mkulesh/digitalAmplifier/photos/Amplifiers/PAM8320.jpg

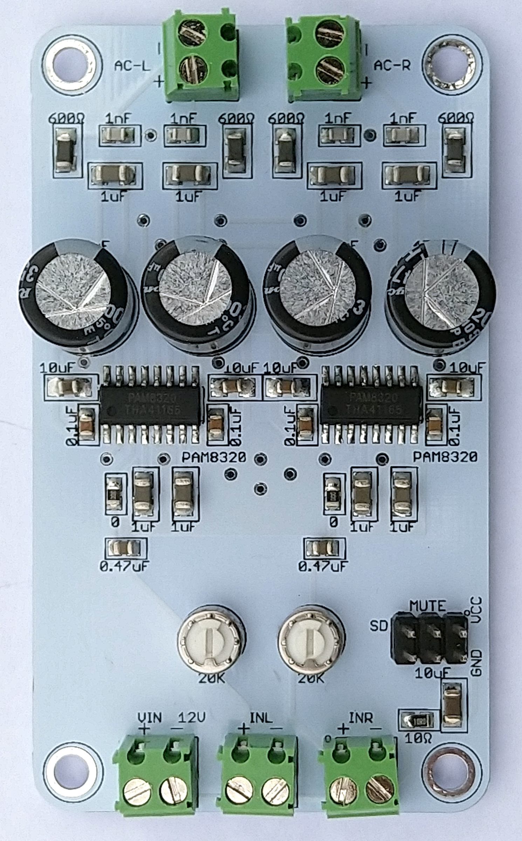
photos/Amplifiers/PAM8320.jpg
