mkulesh/digitalAmplifier/photos/Amplifiers/TPA3125.jpg

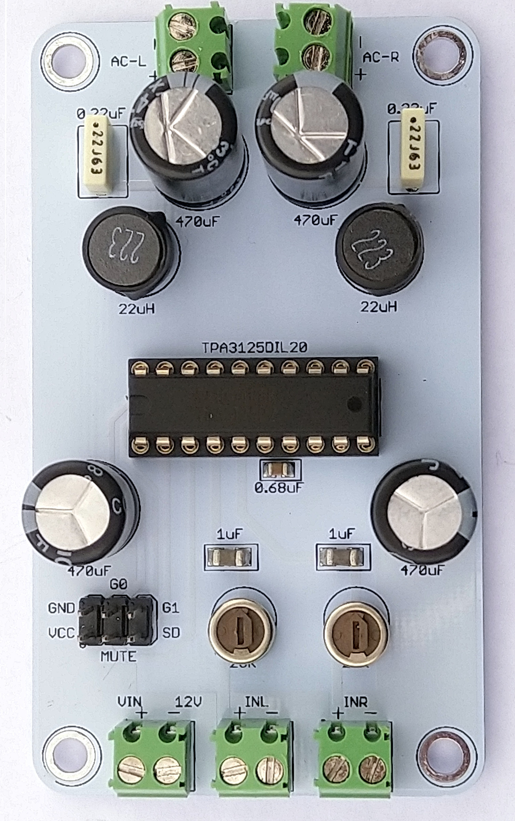
photos/Amplifiers/TPA3125.jpg
