mkulesh/digitalAmplifier/README.md

# digitalAmplifier
Class-D amplifier with MCU controll
