mkulesh/digitalAmplifier/photos/Amplifiers/MP7740.jpg

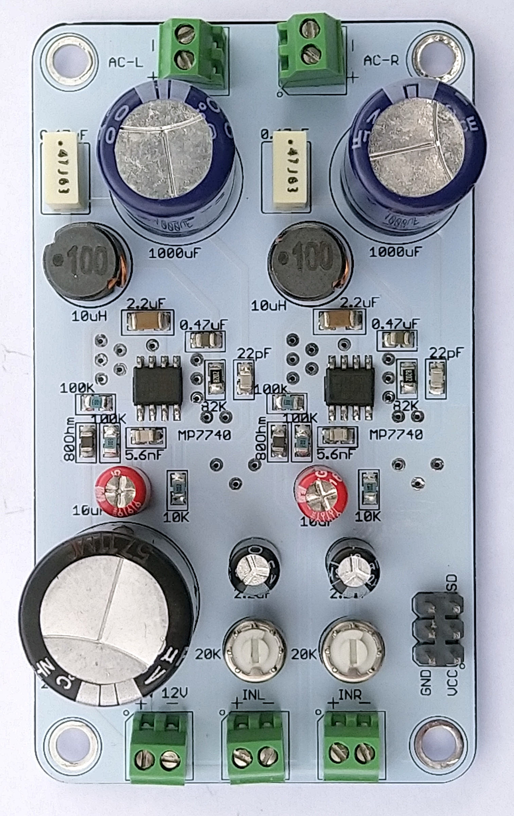
photos/Amplifiers/MP7740.jpg
