mkulesh/digitalAmplifier/photos/Amplifiers/PAM8320-proto.jpg

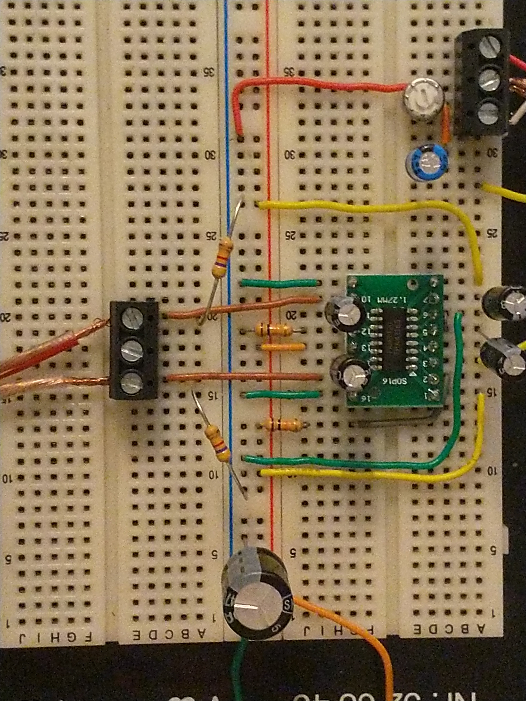
photos/Amplifiers/PAM8320-proto.jpg
