mkulesh/digitalAmplifier/photos/Amplifiers/TDA7297-proto.jpg

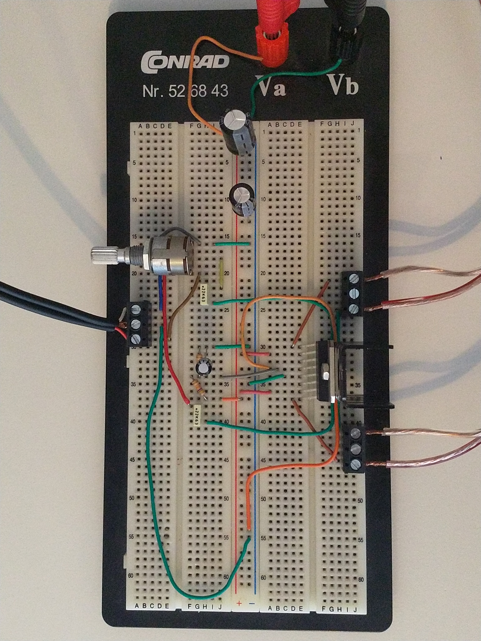
photos/Amplifiers/TDA7297-proto.jpg
