mkulesh/digitalAmplifier/photos/Amplifiers/TPA3125-proto.jpg

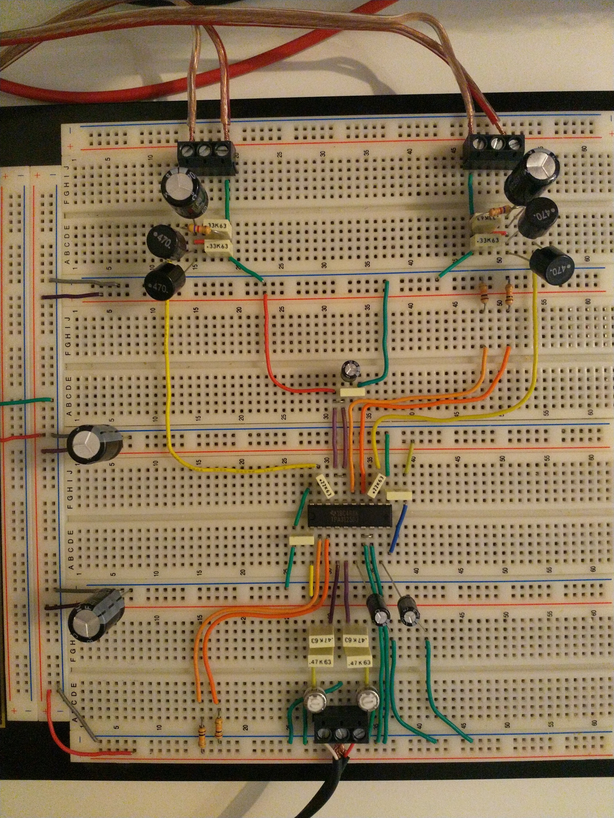
photos/Amplifiers/TPA3125-proto.jpg
