mkulesh/digitalAmplifier/photos/Chasis/Chasis3.jpg

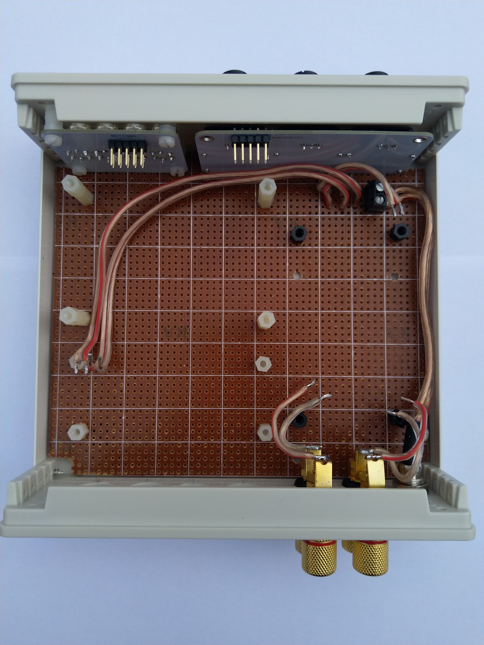
photos/Chasis/Chasis3.jpg
