mkulesh/digitalAmplifier/photos/Inside2.jpg

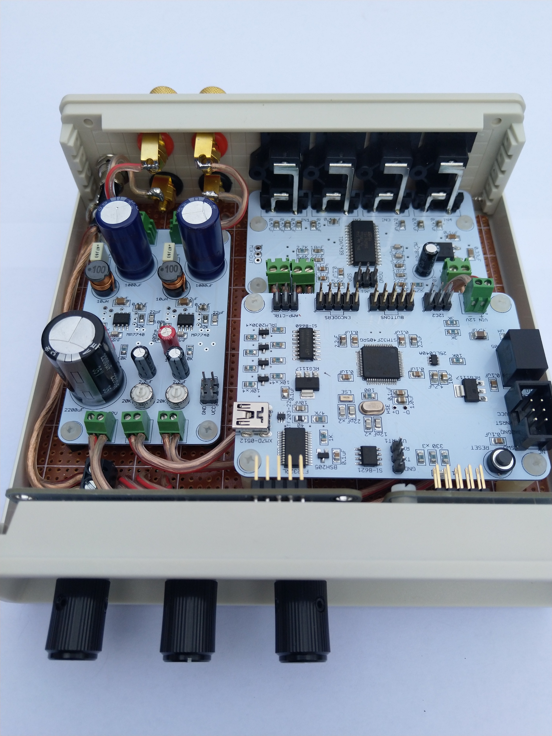
photos/Inside2.jpg
