mkulesh/digitalAmplifier/photos/Modules.jpg

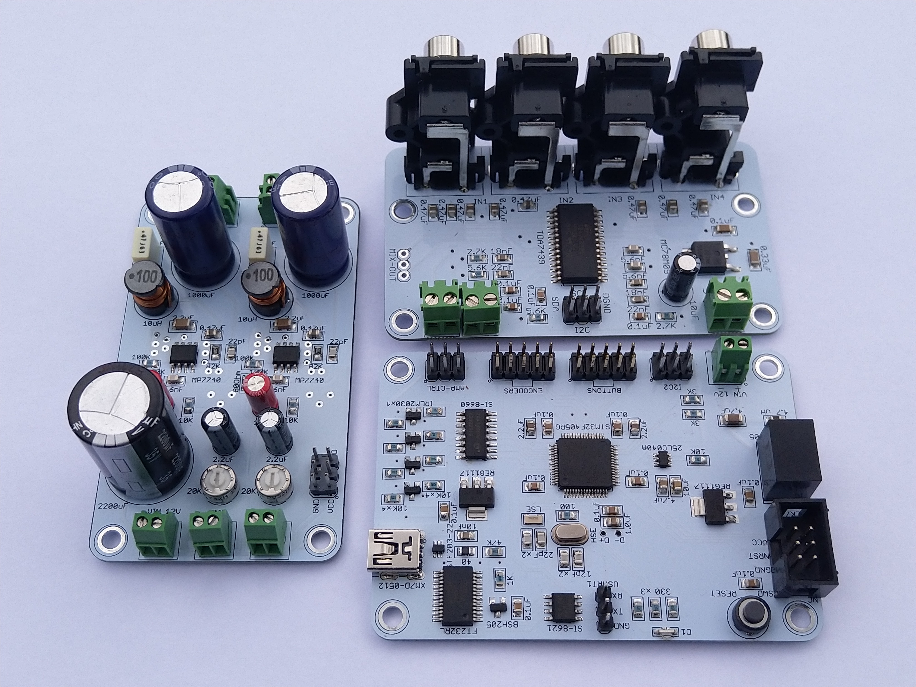
photos/Modules.jpg
