mkulesh/digitalAmplifier/photos/PreAmp/pre-amp.jpg

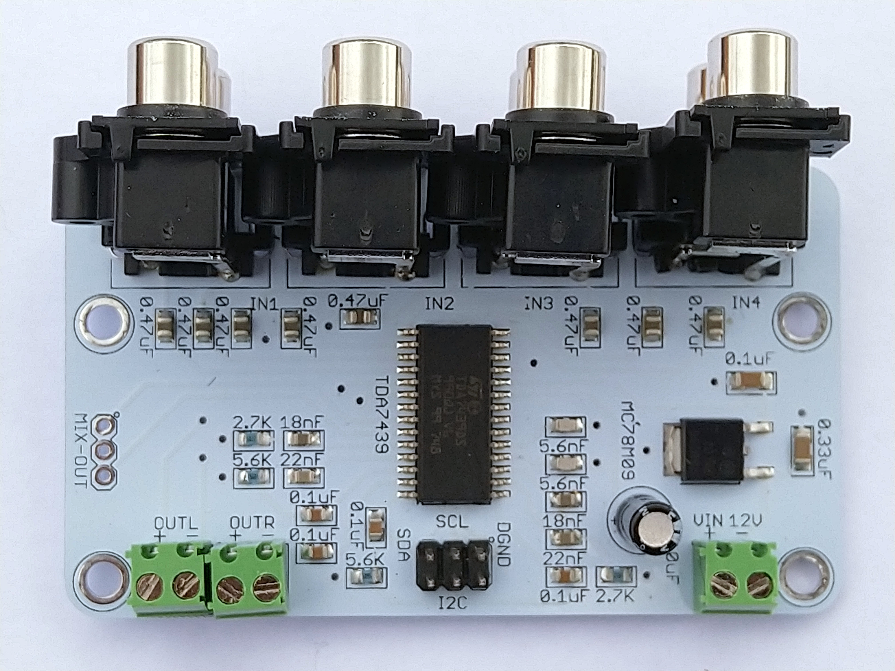
photos/PreAmp/pre-amp.jpg
