mkulesh/digitalAmplifier/photos/Prototypes/Prototype1.jpg

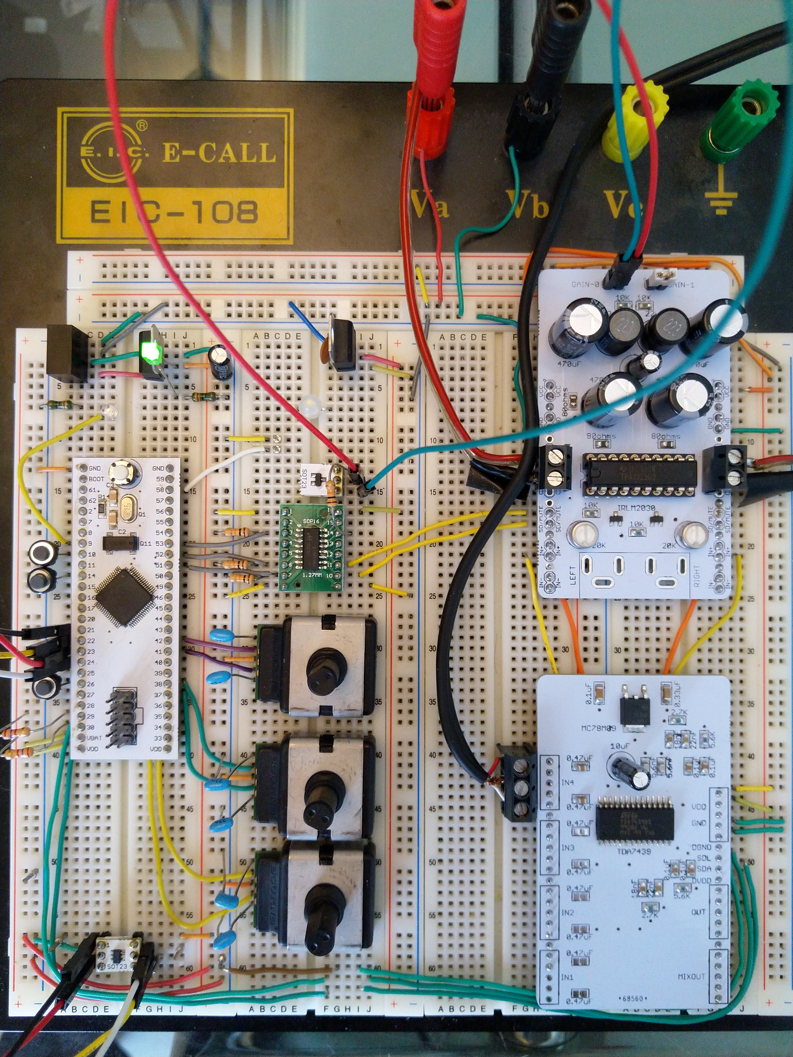
photos/Prototypes/Prototype1.jpg
