mkulesh/digitalAmplifier/photos/Prototypes/Prototype2.jpg

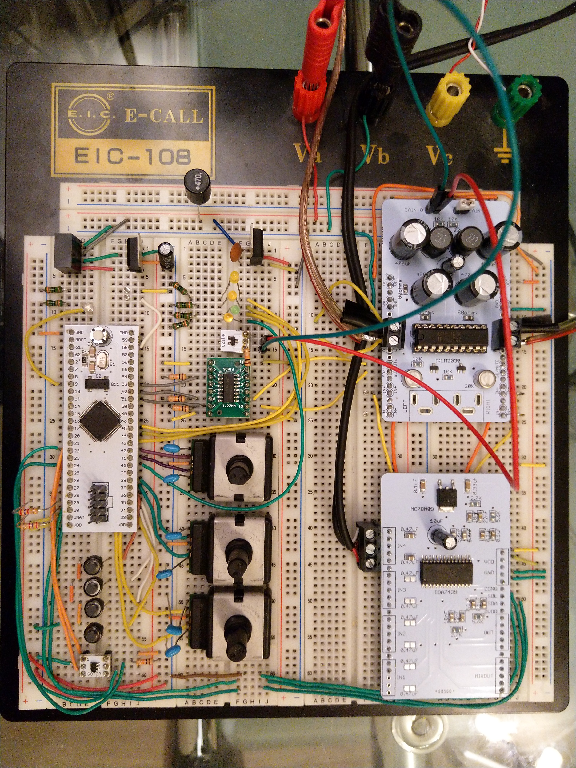
photos/Prototypes/Prototype2.jpg
