mkulesh/digitalAmplifier/photos/Prototypes/Prototype3.jpg

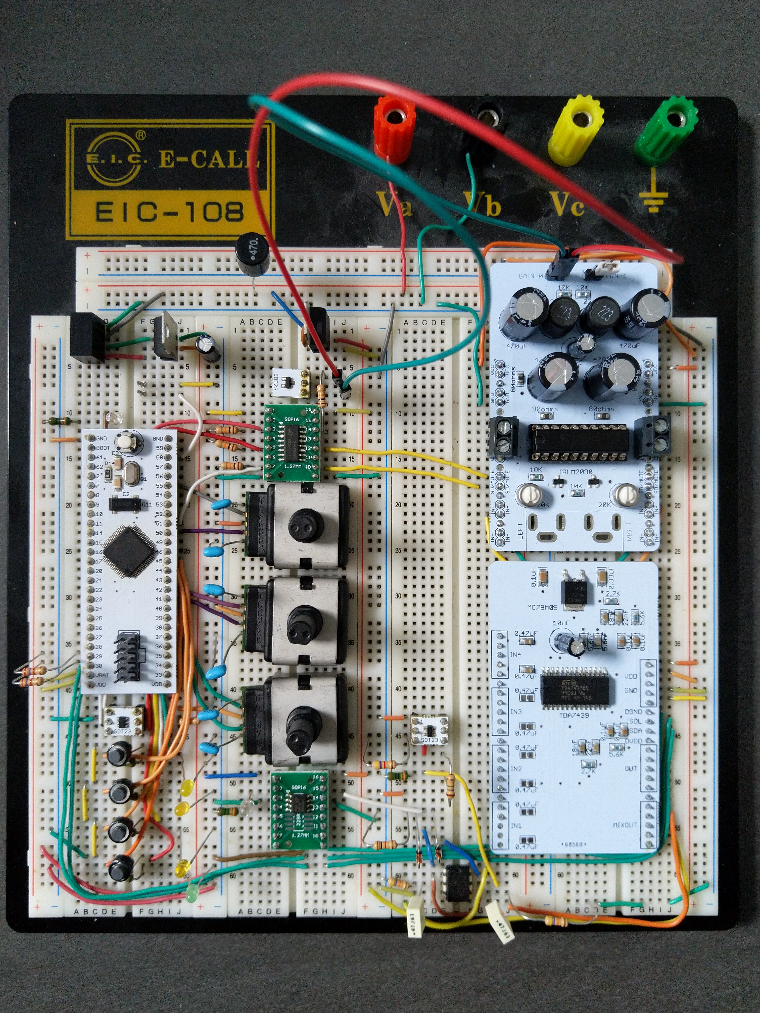
photos/Prototypes/Prototype3.jpg
