mkulesh/digitalAmplifier/photos/Amplifiers/MP7740-schematic.pdf

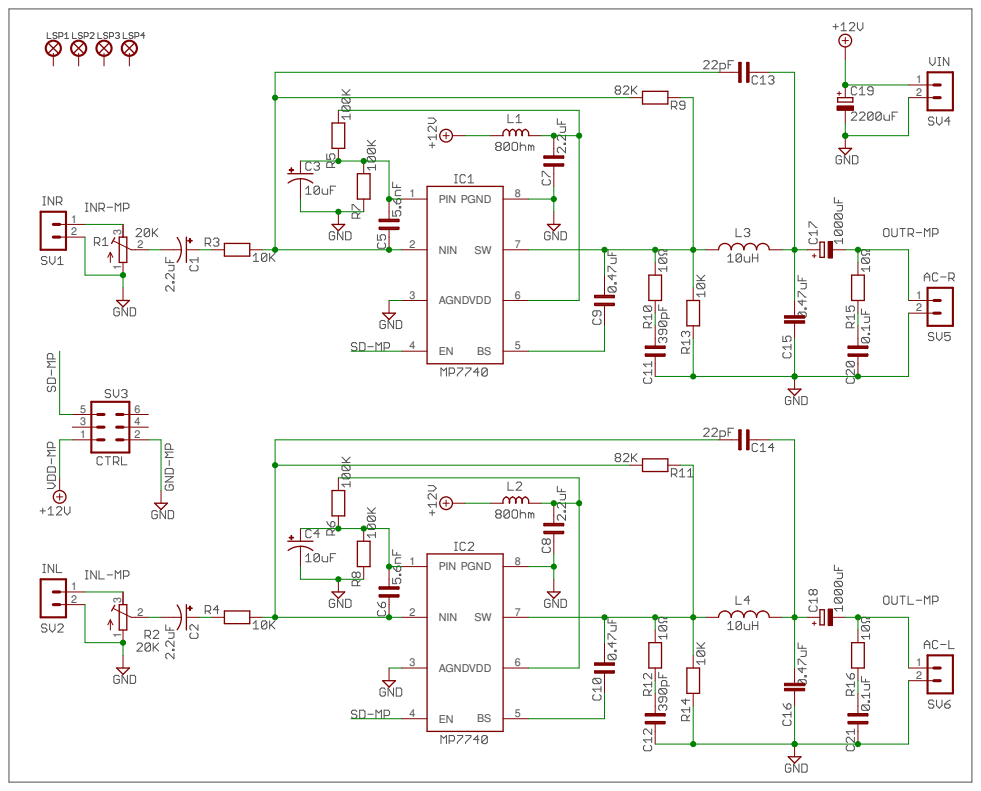
[picture p14: page 1]

1 3 2 1 3 2 1212 1212 135 246 12 PIN 1 NIN 2 AGND 3 EN 4 BS 5 VDD 6 SW 7 PGND 8 PIN 1 NIN 2 AGND 3 EN 4 BS 5 VDD 6 SW 7 PGND 8
