mkulesh/digitalAmplifier/photos/Amplifiers/PAM8320-schematic.pdf

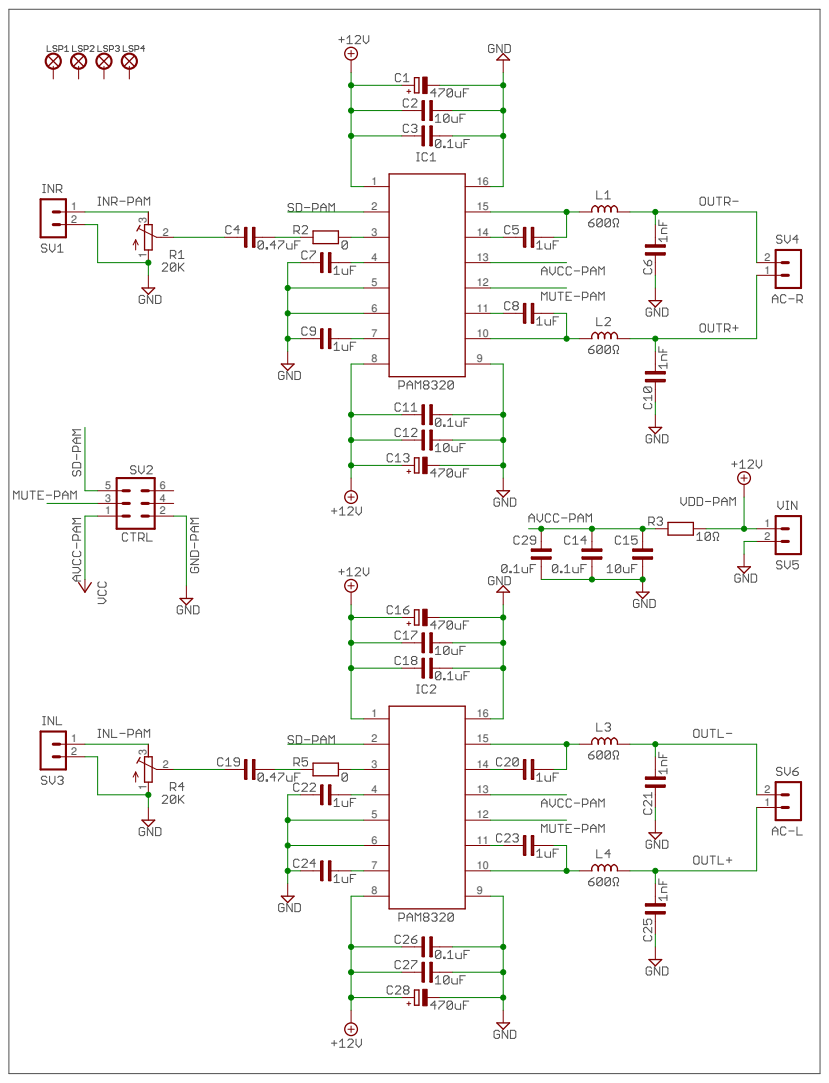
[picture p15: page 1]
