mkulesh/digitalAmplifier/photos/Amplifiers/TPA3125-schematic.pdf

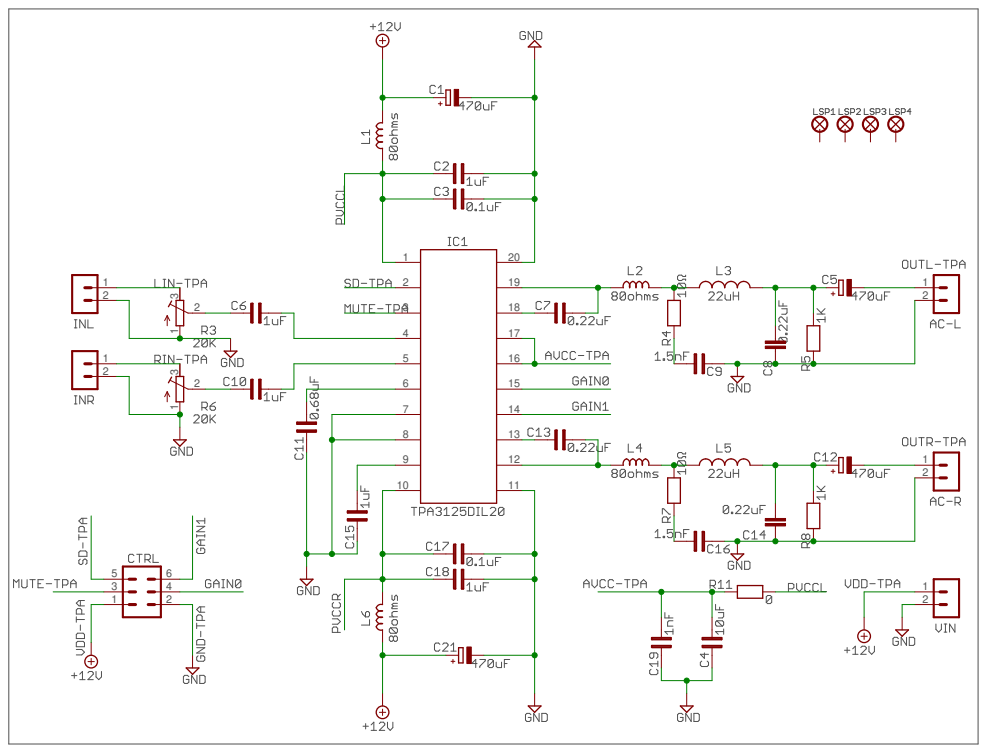
[picture p16: page 1]
