mkulesh/digitalAmplifier/photos/Mcu/mcu-components.pdf

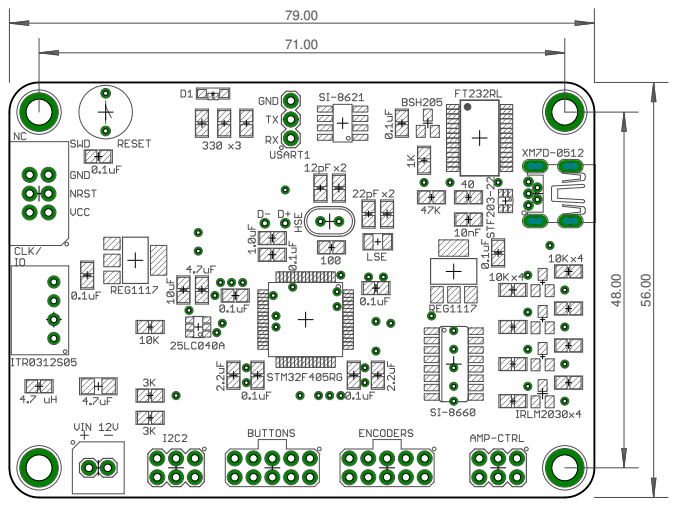
[picture p17: page 1]
