mkulesh/digitalAmplifier/photos/Mcu/mcu-schematic.pdf

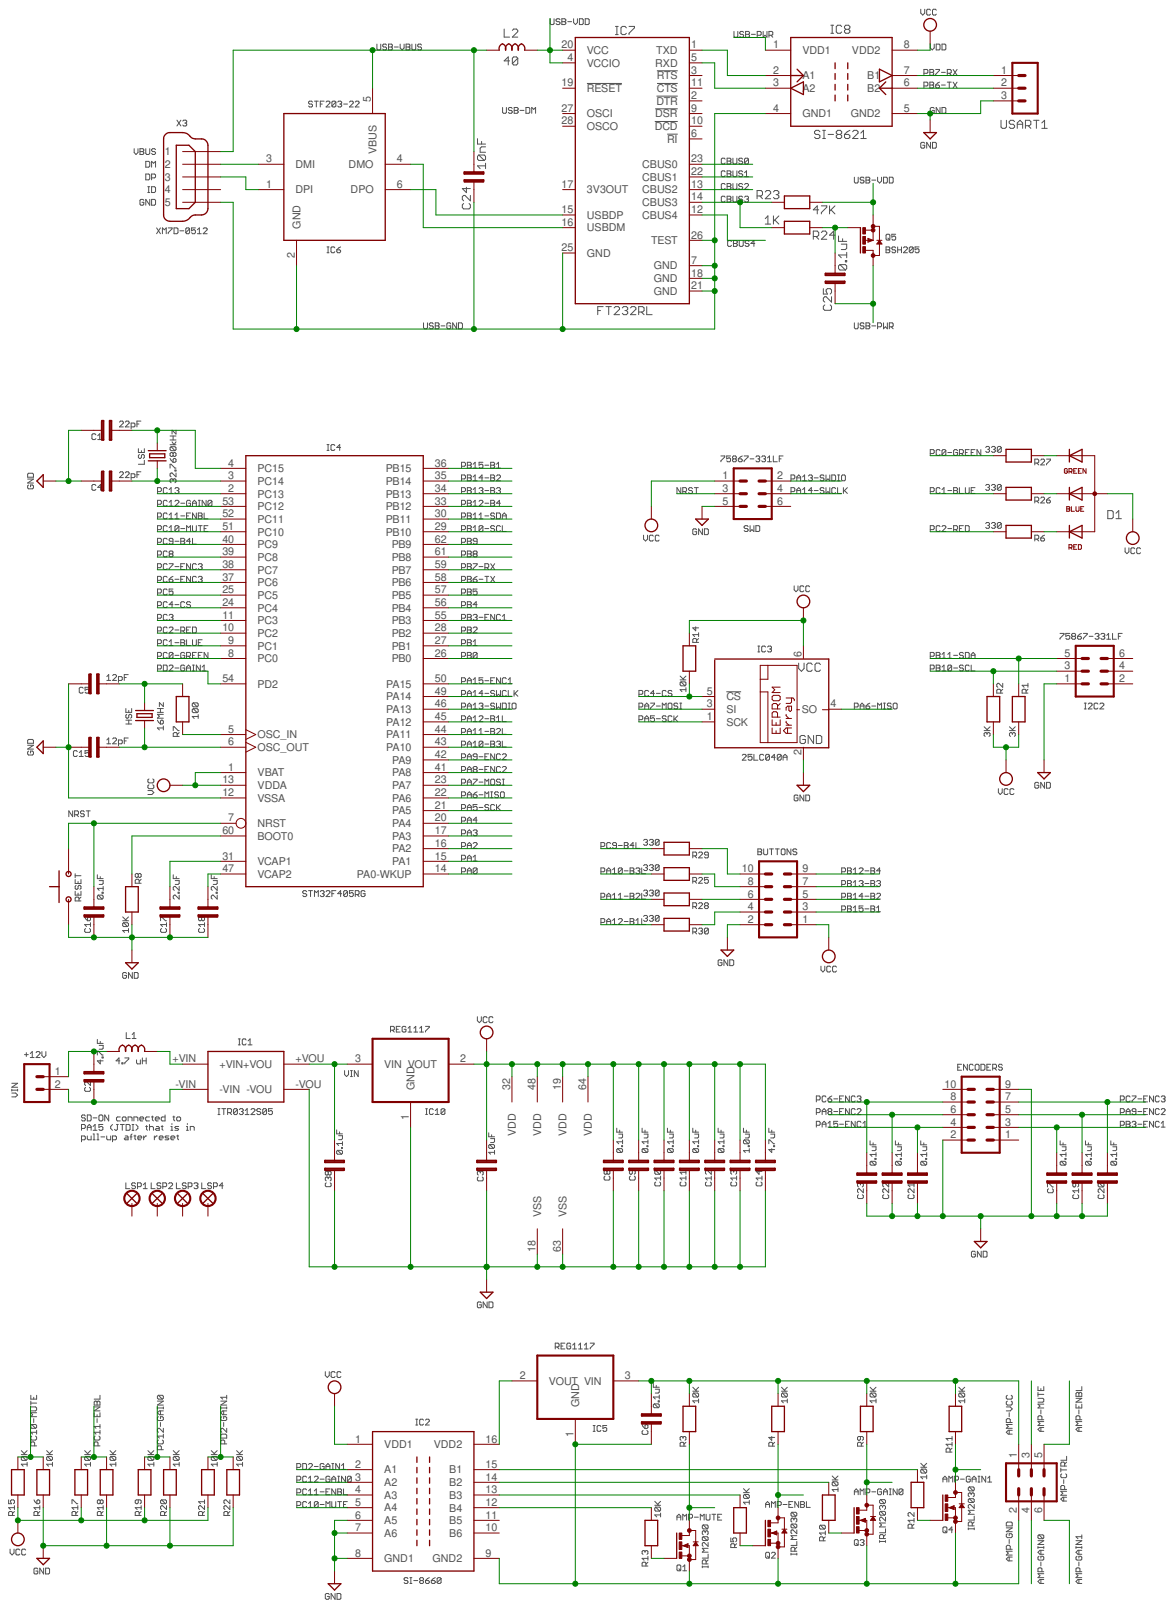
[picture p18: page 1]
