mkulesh/digitalAmplifier/photos/PreAmp/pre-amp-components.pdf

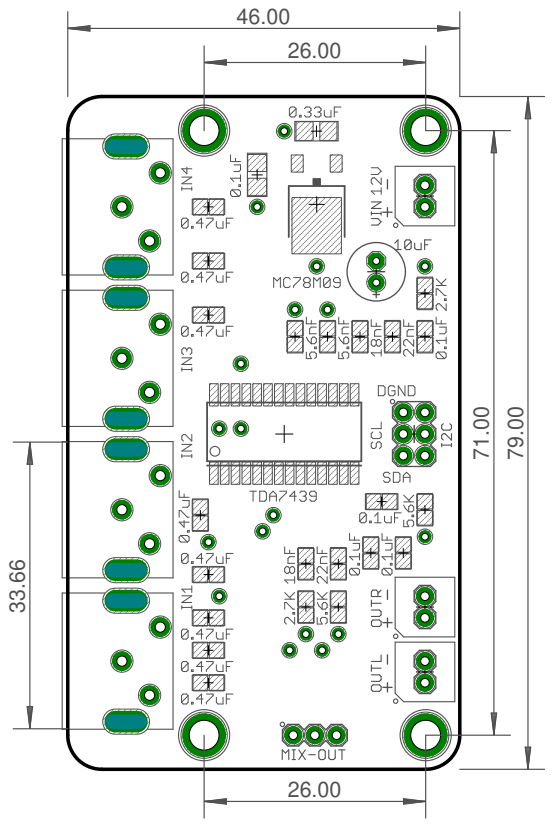
[picture p19: page 1]
