mkulesh/digitalAmplifier/photos/PreAmp/pre-amp-schematic.pdf

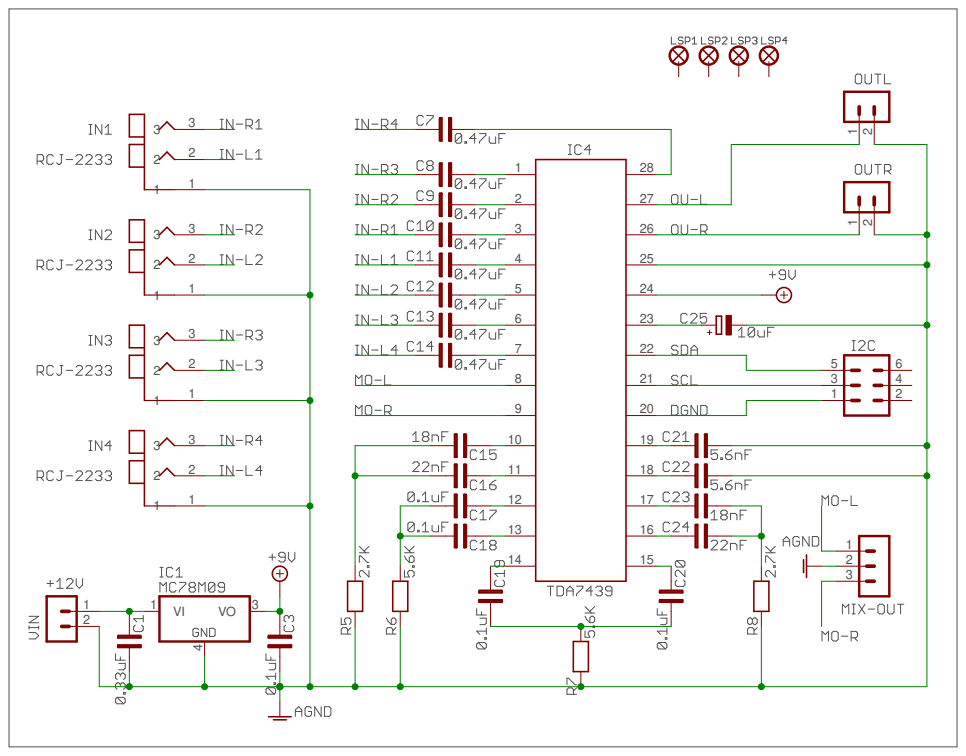
[picture p20: page 1]
