mkulesh/digitalAmplifier/photos/Amplifiers/MP7740-bottom.pdf

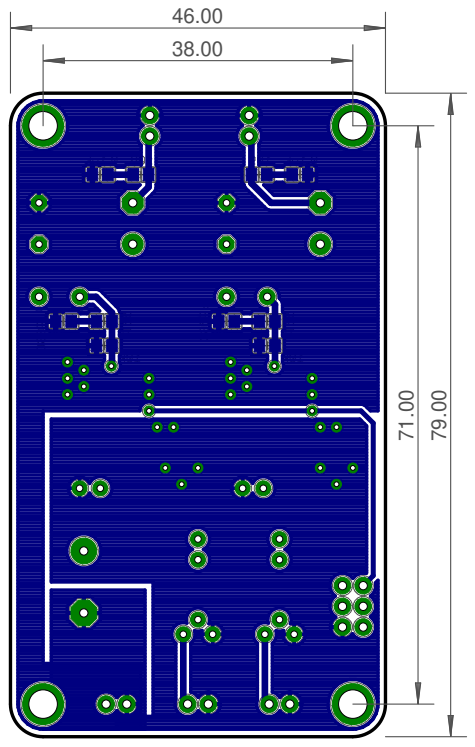
[picture p21: page 1]
