mkulesh/digitalAmplifier/photos/Amplifiers/MP7740-top.pdf

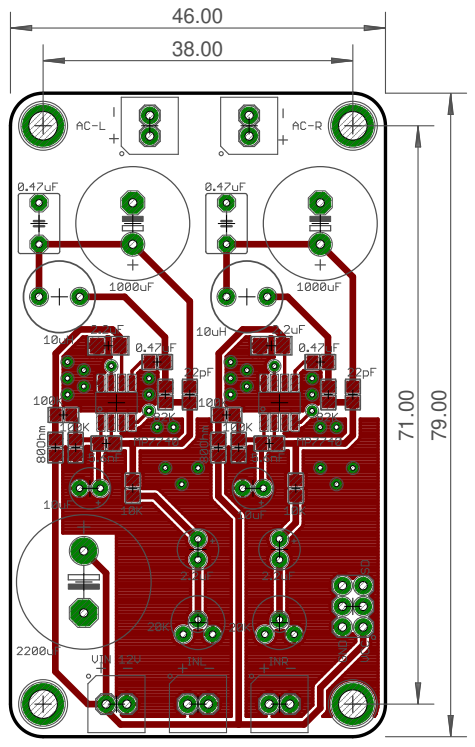
[picture p22: page 1]
