mkulesh/digitalAmplifier/photos/Amplifiers/PAM8320-bottom.pdf

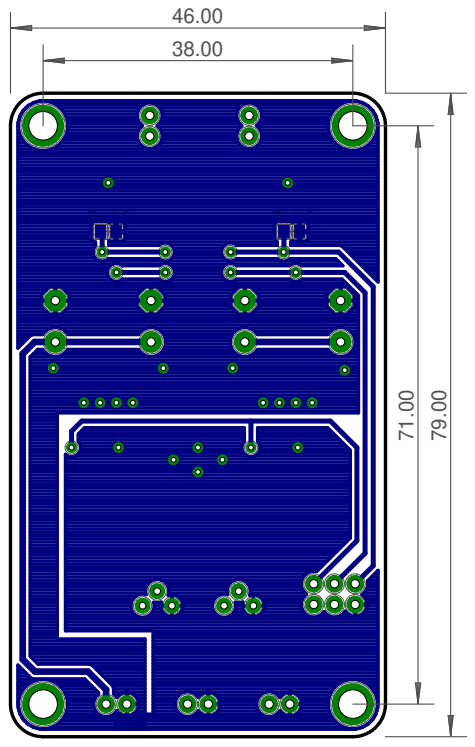
[picture p23: page 1]
