mkulesh/digitalAmplifier/photos/Amplifiers/PAM8320-top.pdf

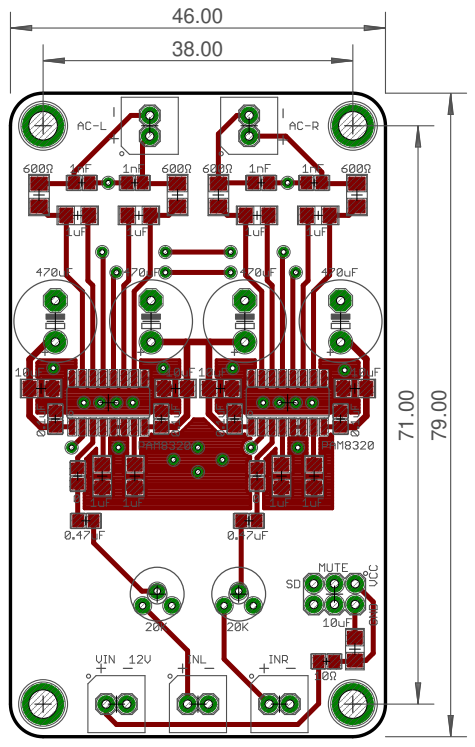
[picture p24: page 1]
