mkulesh/digitalAmplifier/photos/Amplifiers/TPA3125-bottom.pdf

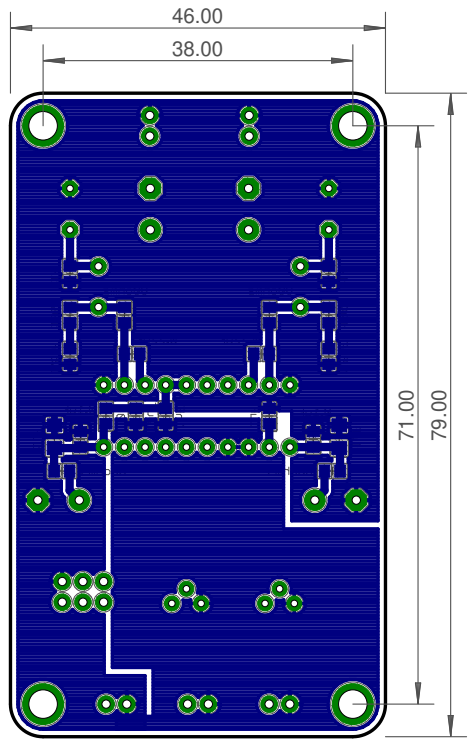
[picture p25: page 1]
