mkulesh/digitalAmplifier/photos/Amplifiers/TPA3125-top.pdf

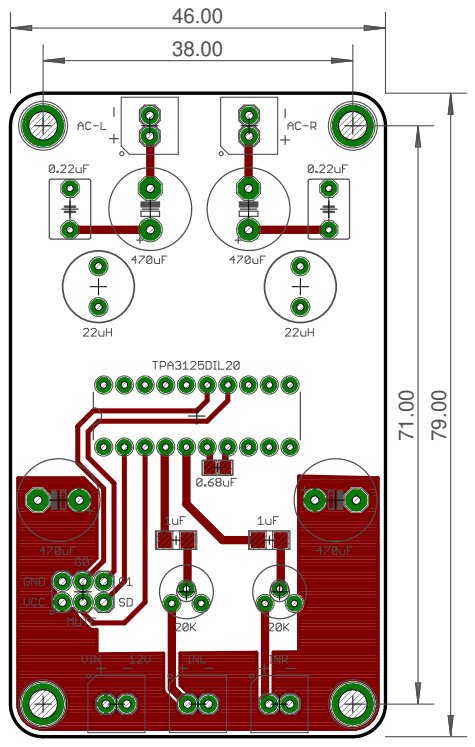
[picture p26: page 1]
