mkulesh/digitalAmplifier/photos/Mcu/mcu-bottom.pdf

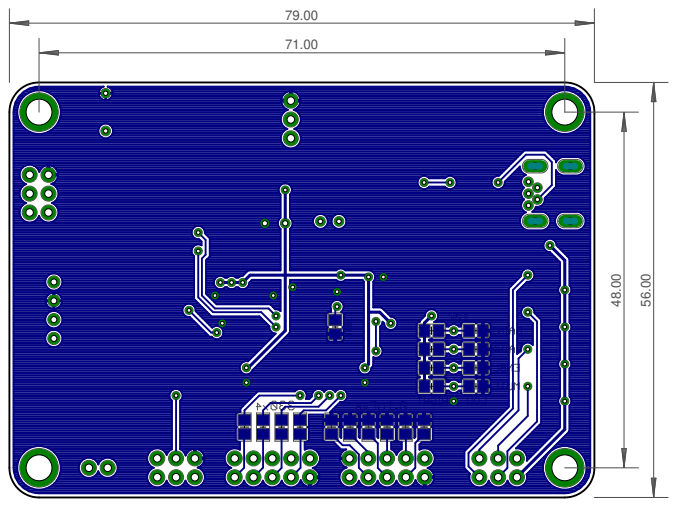
[picture p27: page 1]
