mkulesh/digitalAmplifier/photos/Mcu/mcu-top.pdf

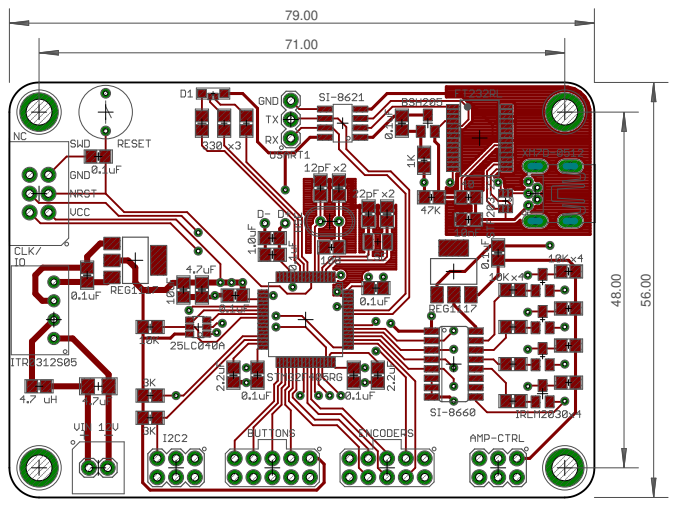
[picture p28: page 1]
