mkulesh/digitalAmplifier/photos/PreAmp/pre-amp-bottom.pdf

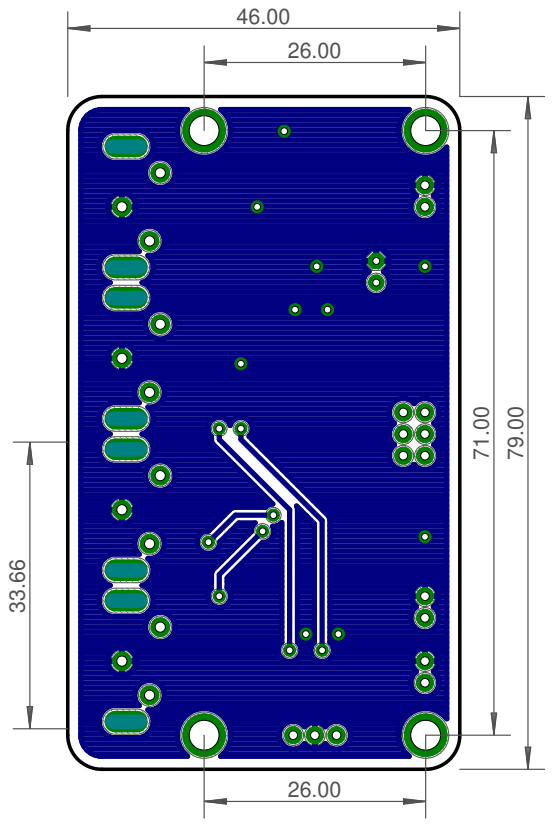
[picture p29: page 1]
