mkulesh/digitalAmplifier/photos/PreAmp/pre-amp-top.pdf

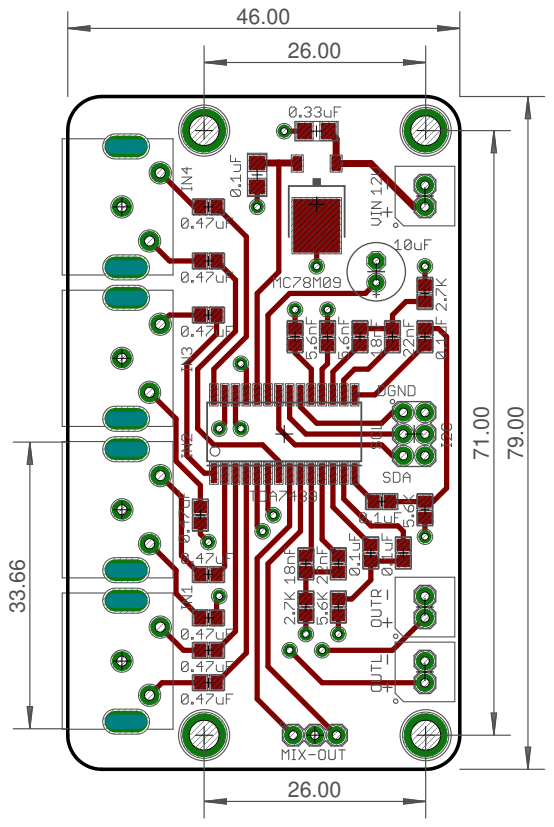
[picture p30: page 1]
