mkulesh/digitalAmplifier/pcb/module-tpa3125.brd

## EAGLE design pcb/module-tpa3125.brd (2021-05-24)

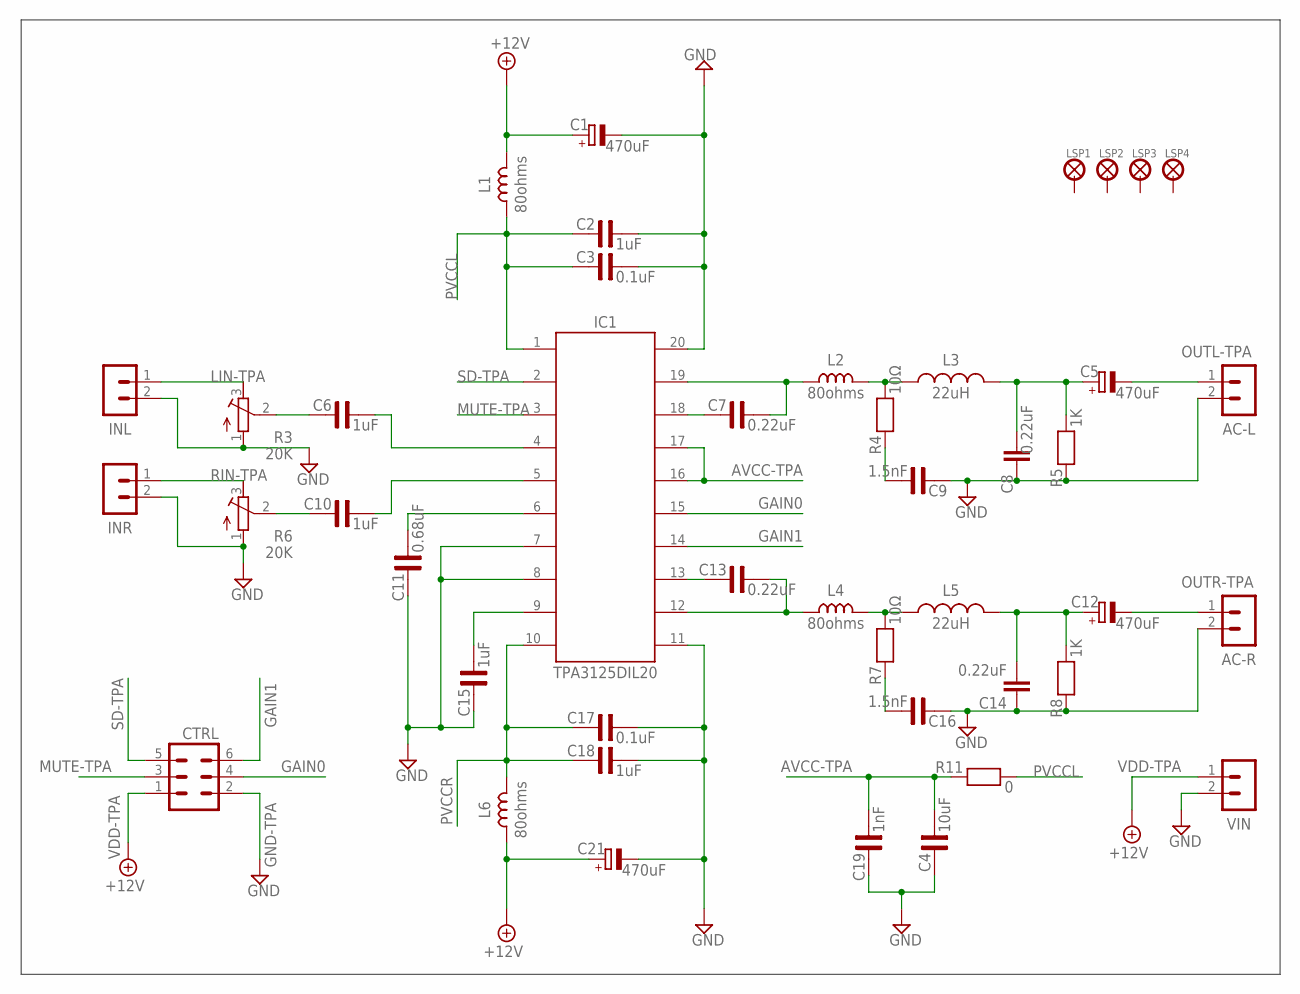
[picture p31: schematic module-tpa3125.sch]

Parts:
AC-L: MA02-1GREEN; MA02-1-GREEN
AC-R: MA02-1GREEN; MA02-1-GREEN
C1, C5, C12, C21: 470uF; E5-10,5
C2, C6, C10, C18: 1uF; C1206
C3, C17: 0.1uF; C0805
C4: 10uF; C0805
C7, C13: 0.22uF; C0805
C8, C14: 0.22uF; C050-050X075
C9, C16: 1.5nF; C0805
C11: 0.68uF; C0805
C15: 1uF; C0805
C19: 1nF; C0805
CTRL: MA03-2
IC1: TPA3125DIL20; DIL20
INL: MA02-1GREEN; MA02-1-GREEN
INR: MA02-1GREEN; MA02-1-GREEN
L1, L2, L4, L6: 80ohms; L0805
L3, L5: 22uH; 6000-XXXX-RC
LSP1, LSP2, LSP3, LSP4: LSP27
R3, R6: 20K; PV32H
R4, R7: 10Ω; R0805
R5, R8: 1K; R0805
R11: 0; R0805
VIN: MA02-1GREEN; MA02-1-GREEN

Connections:
AVCC-TPA: C4.2, C19.2, IC1.16, IC1.17, R11.1
GAIN0: CTRL.4, IC1.15
GAIN1: CTRL.6, IC1.14
GND-TPA: AC-L.2, AC-R.2, C1.-, C2.2, C3.2, C4.1, C8.1, C9.1, C11.1, C14.1, C15.1, C16.1, C17.2, C18.2, C19.1, C21.-, CTRL.2, IC1.7, IC1.8, IC1.11, IC1.20, INL.2, INR.2, R3.1, R5.1, R6.1, R8.1, VIN.2
LIN-TPA: INL.1, R3.3
MUTE-TPA: CTRL.3, IC1.3
unnamed: C10.1, R6.2
unnamed: C13.1, IC1.13
unnamed: C6.1, R3.2
unnamed: C6.2, IC1.4
unnamed: C10.2, IC1.5
unnamed: C11.2, IC1.6
unnamed: C15.2, IC1.9
unnamed: C7.1, IC1.18
unnamed: C7.2, IC1.19, L2.1
unnamed: C9.2, R4.1
unnamed: L2.2, L3.1, R4.2
unnamed: C5.+, C8.2, L3.2, R5.2
unnamed: C16.2, R7.1
unnamed: L4.2, L5.1, R7.2
unnamed: C12.+, C14.2, L5.2, R8.2
unnamed: C13.2, IC1.12, L4.1
OUTL-TPA: AC-L.1, C5.-
OUTR-TPA: AC-R.1, C12.-
PVCCL: C2.1, C3.1, IC1.1, L1.1, R11.2
PVCCR: C17.1, C18.1, IC1.10, L6.2
RIN-TPA: INR.1, R6.3
SD-TPA: CTRL.5, IC1.2
VDD-TPA: C1.+, C21.+, CTRL.1, L1.2, L6.1, VIN.1

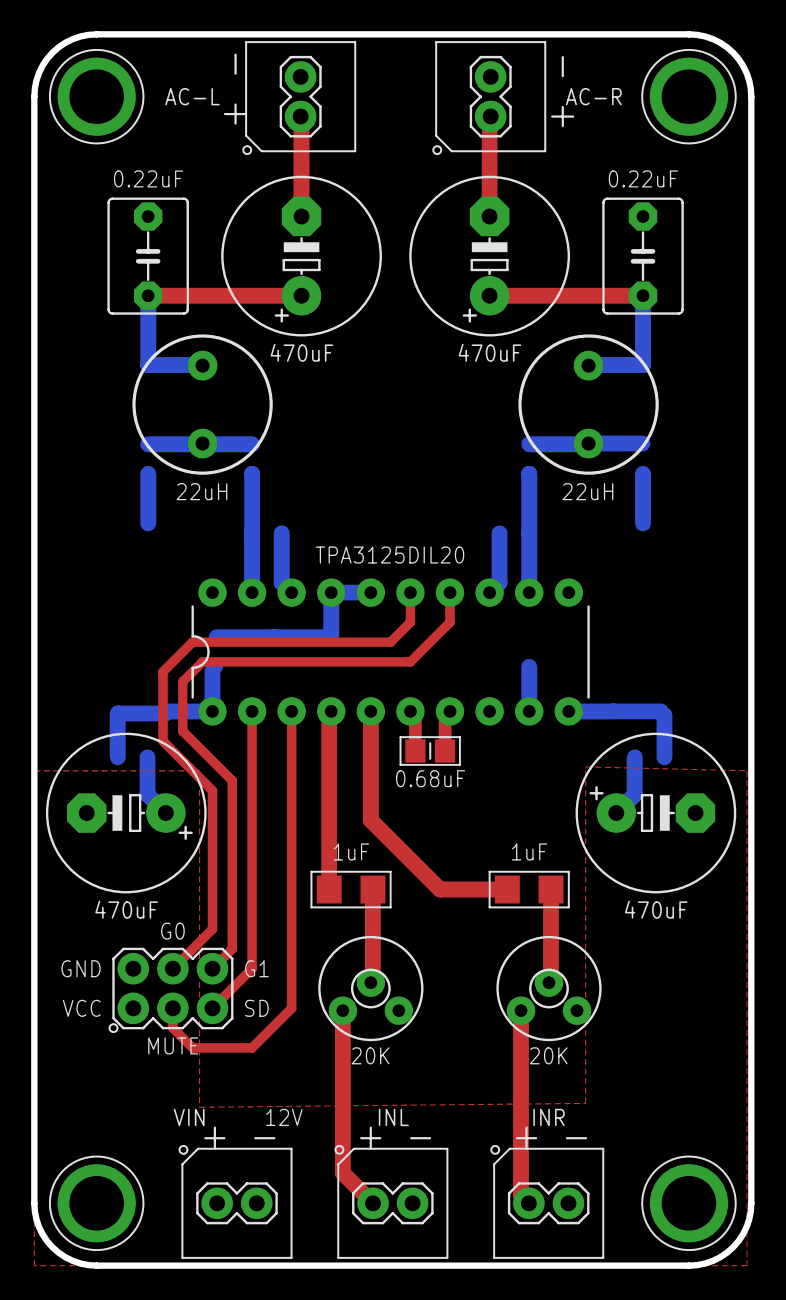
[picture p32: board module-tpa3125.brd from above]

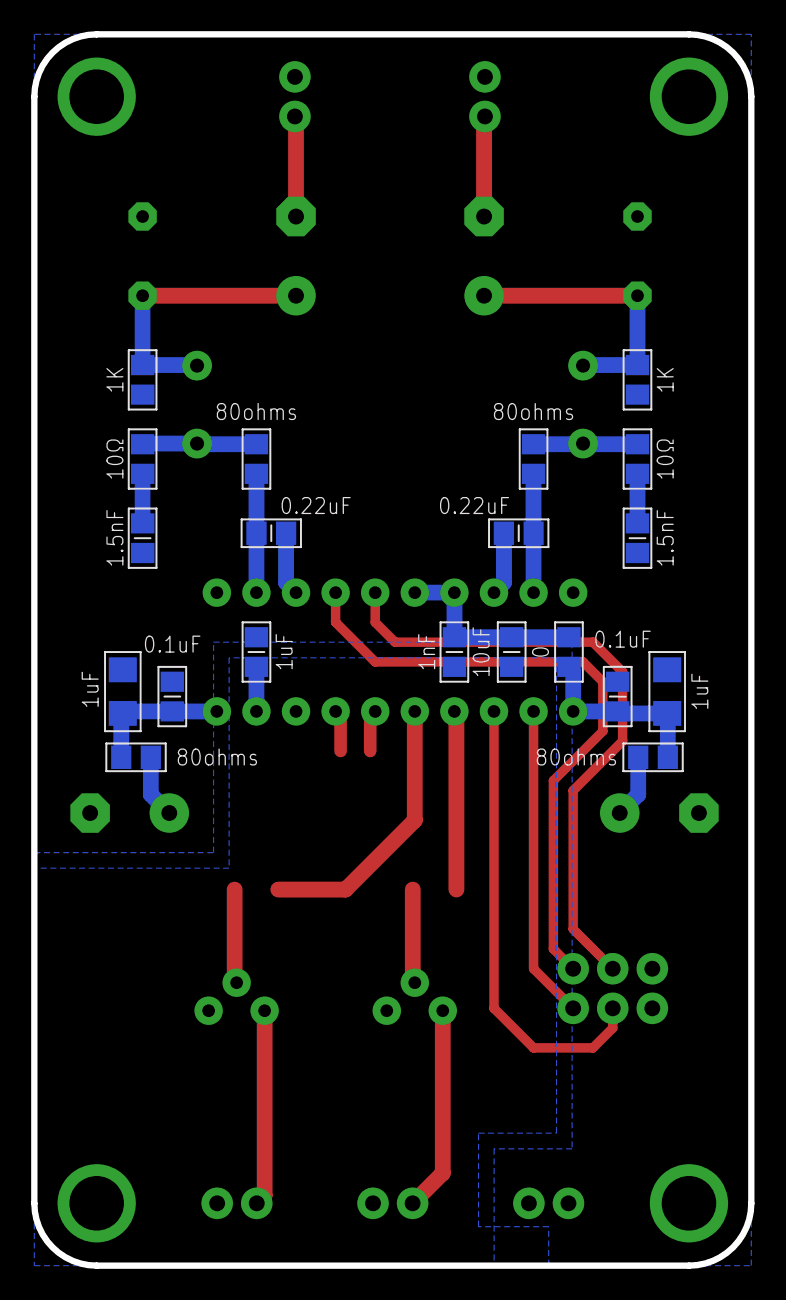
[picture p33: board module-tpa3125.brd from below]

Board: 2 copper layers, 46.0 x 79.0 mm, 44 parts (20 on the bottom side), 29 nets.
