mkulesh/digitalAmplifier/pcb/module-pam8320.brd

## EAGLE design pcb/module-pam8320.brd (2021-05-24)

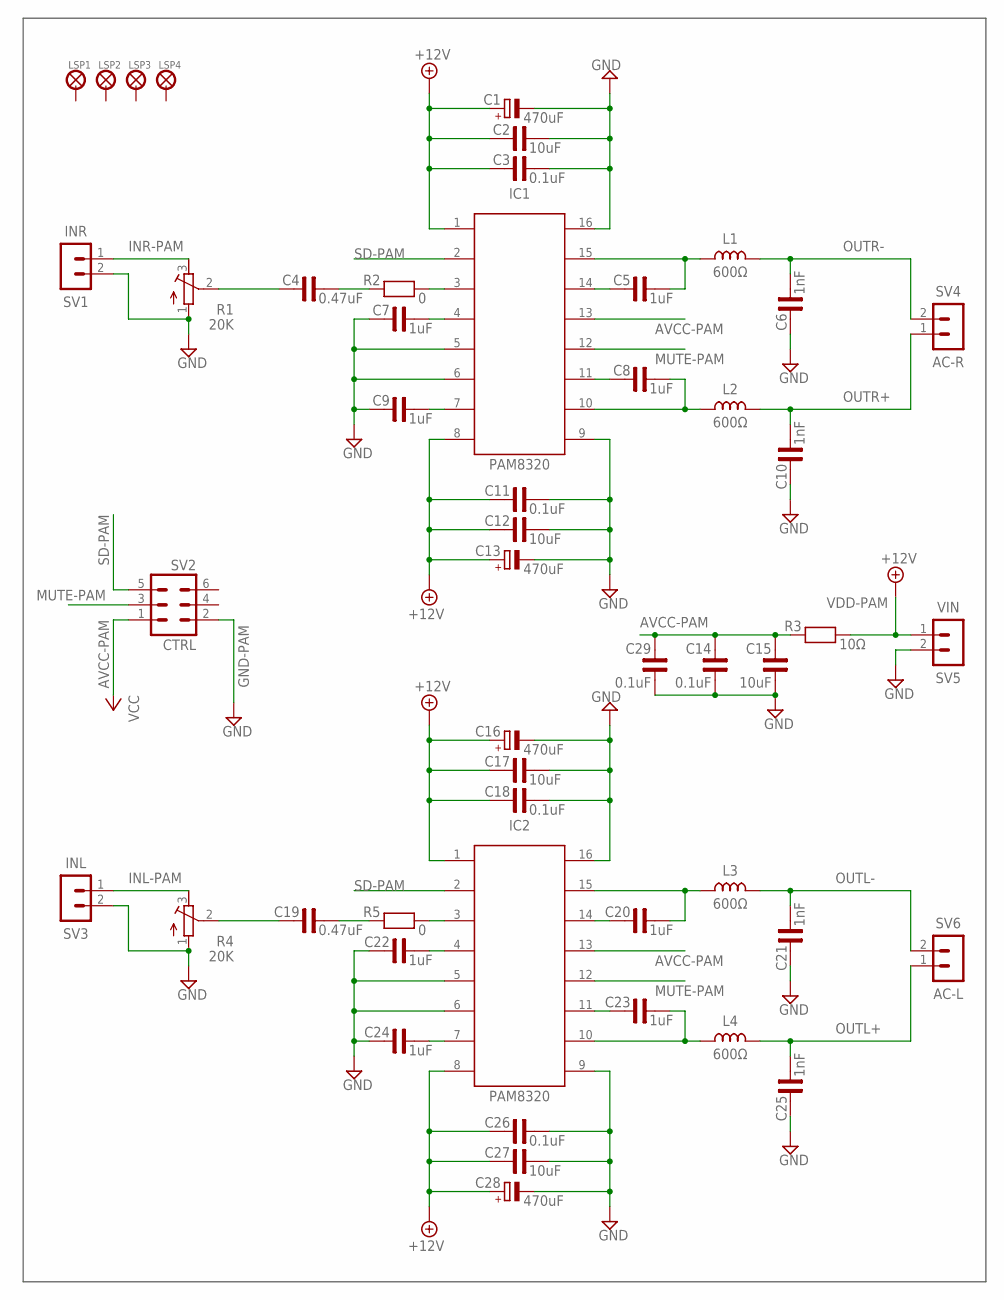
[picture p34: schematic module-pam8320.sch]

Parts:
C1, C13, C16, C28: 470uF; E5-10,5
C2, C12, C15, C17, C27: 10uF; C1206
C3, C11, C14, C18, C26, C29: 0.1uF; C0805
C4, C19: 0.47uF; C0805
C5, C7, C8, C9, C20, C22, C23, C24: 1uF; C1206
C6, C10, C21, C25: 1nF; C0805
IC1, IC2: PAM8320; SO16
L1, L2, L3, L4: 600Ω; L1206
LSP1, LSP2, LSP3, LSP4: LSP27
R1, R4: 20K; PV32H
R2, R5: 0; R0805
R3: 10Ω; R0805
SV1: INR; MA02-1-GREEN
SV2: CTRL; MA03-2
SV3: INL; MA02-1-GREEN
SV4: AC-R; MA02-1-GREEN
SV5: VIN; MA02-1-GREEN
SV6: AC-L; MA02-1-GREEN

Connections:
AVCC-PAM: C14.2, C15.2, C29.2, IC1.13, IC2.13, R3.1, SV2.1
GND-PAM: C1.-, C2.2, C3.2, C6.1, C7.1, C9.1, C10.1, C11.2, C12.2, C13.-, C14.1, C15.1, C16.-, C17.2, C18.2, C21.1, C22.1, C24.1, C25.1, C26.2, C27.2, C28.-, C29.1, IC1.5, IC1.6, IC1.9, IC1.16, IC2.5, IC2.6, IC2.9, IC2.16, R1.1, R4.1, SV1.2, SV2.2, SV3.2, SV5.2
INL-PAM: R4.3, SV3.1
INR-PAM: R1.3, SV1.1
MUTE-PAM: IC1.12, IC2.12, SV2.3
unnamed: IC1.3, R2.2
unnamed: C4.1, R1.2
unnamed: C22.2, IC2.4
unnamed: C4.2, R2.1
unnamed: C24.2, IC2.7
unnamed: C5.1, IC1.14
unnamed: C7.2, IC1.4
unnamed: C9.2, IC1.7
unnamed: C5.2, IC1.15, L1.1
unnamed: C8.1, IC1.11
unnamed: C8.2, IC1.10, L2.1
unnamed: C19.1, R4.2
unnamed: IC2.3, R5.2
unnamed: C19.2, R5.1
unnamed: C20.1, IC2.14
unnamed: C20.2, IC2.15, L3.1
unnamed: C23.1, IC2.11
unnamed: C23.2, IC2.10, L4.1
OUTL+: C25.2, L4.2, SV6.1
OUTL-: C21.2, L3.2, SV6.2
OUTR+: C10.2, L2.2, SV4.1
OUTR-: C6.2, L1.2, SV4.2
SD-PAM: IC1.2, IC2.2, SV2.5
VDD-PAM: C1.+, C2.1, C3.1, C11.1, C12.1, C13.+, C16.+, C17.1, C18.1, C26.1, C27.1, C28.+, IC1.1, IC1.8, IC2.1, IC2.8, R3.2, SV5.1

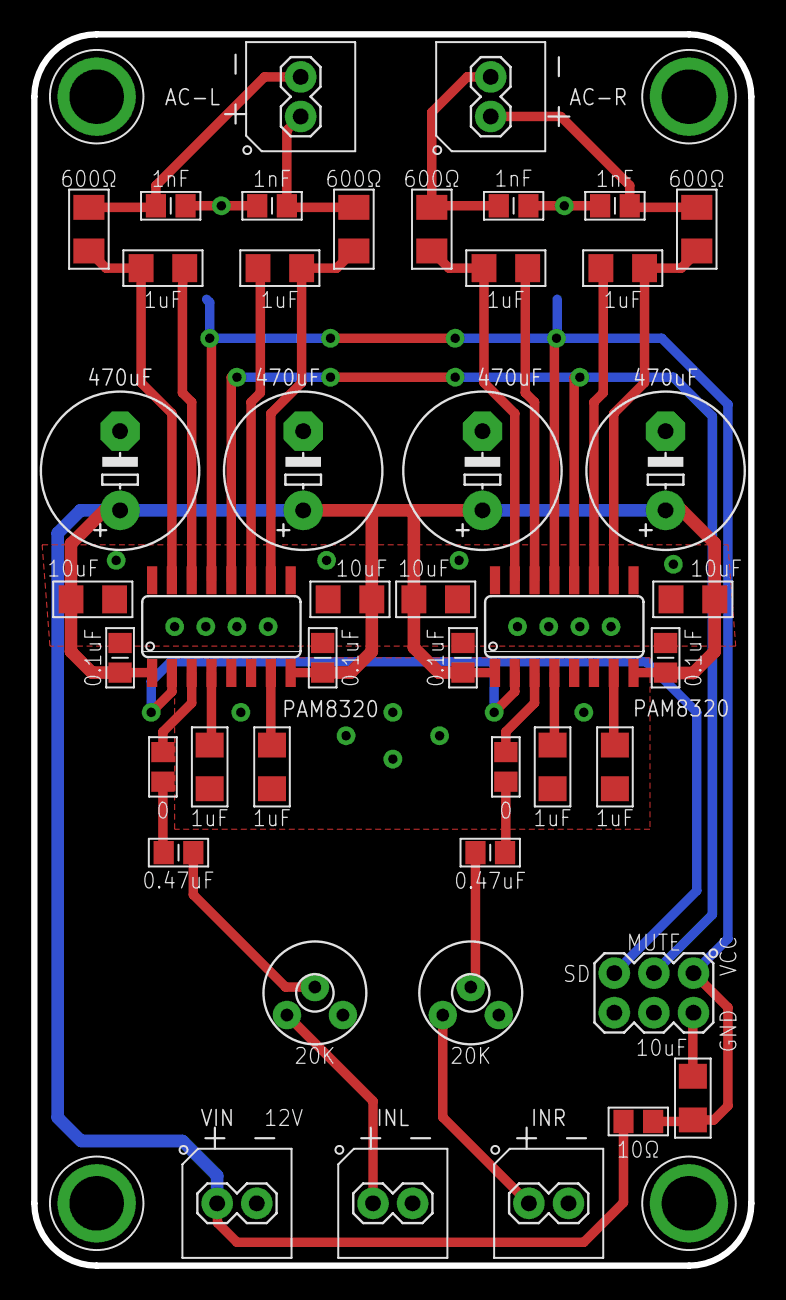
[picture p35: board module-pam8320.brd from above]

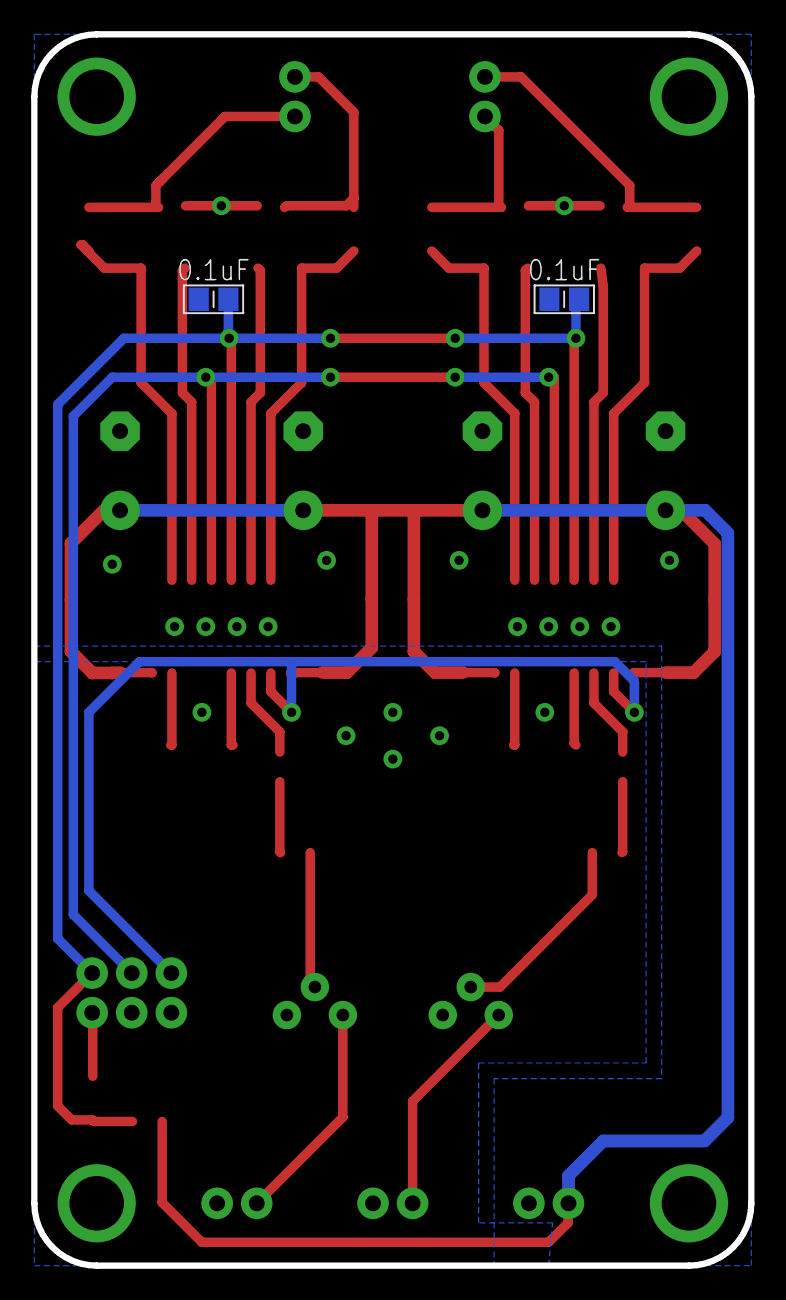
[picture p36: board module-pam8320.brd from below]

Board: 2 copper layers, 46.0 x 79.0 mm, 50 parts (2 on the bottom side), 29 nets.
