mkulesh/digitalAmplifier/pcb/module-pre-amp.brd

## EAGLE design pcb/module-pre-amp.brd (2021-05-24)

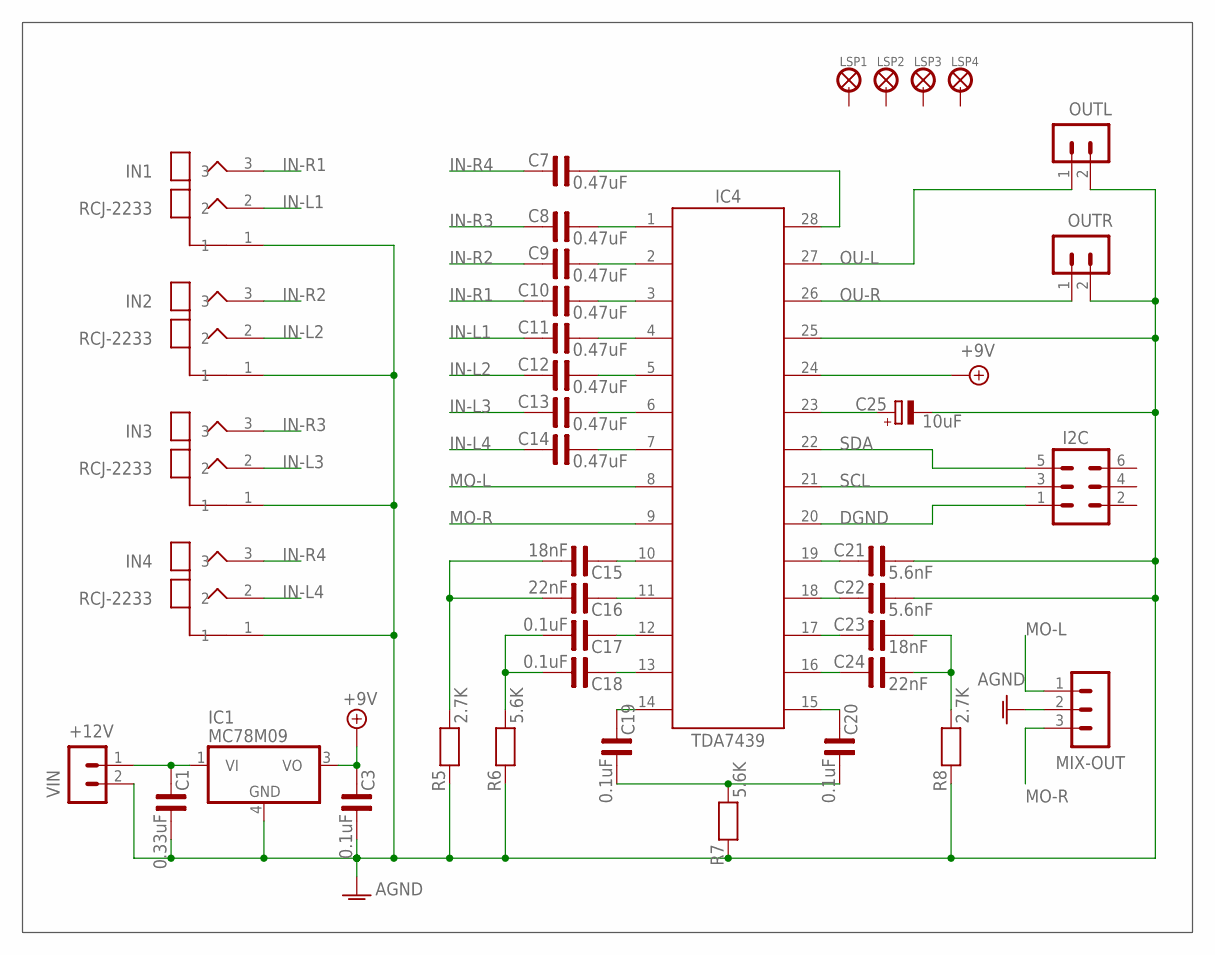
[picture p37: schematic module-pre-amp.sch]

Parts:
C1: 0.33uF; C1206
C3: 0.1uF; C1206
C7, C8, C9, C10, C11, C12, C13, C14: 0.47uF; C0805
C15, C23: 18nF; C0805
C16, C24: 22nF; C0805
C17, C18, C19, C20: 0.1uF; C0805
C21, C22: 5.6nF; C0805
C25: 10uF; E2,5-7
I2C: MA03-2
IC1: MC78M09; DPACK_3
IC4: TDA7439; SO28W
IN1, IN2, IN3, IN4: RCJ-2233
LSP1, LSP2, LSP3, LSP4: LSP27
MIX-OUT: MA03-1PL; MA03-1
OUTL: MA02-1GREEN; MA02-1-GREEN
OUTR: MA02-1GREEN; MA02-1-GREEN
R5, R8: 2.7K; R0805
R6, R7: 5.6K; R0805
VIN: MA02-1GREEN; MA02-1-GREEN

Connections:
+12V: C1.1, IC1.1 (VI), VIN.1
AGND: C1.2, C3.2, C21.2, C22.2, C25.-, IC1.4 (GND), IC4.25, IN1.1, IN2.1, IN3.1, IN4.1, MIX-OUT.2, OUTL.2, OUTR.2, R5.1, R6.1, R7.1, R8.1, VIN.2
AVDD: C3.1, IC1.3 (VO), IC4.24
DGND: I2C.1, IC4.20
IN-L1: C11.1, IN1.2
IN-L2: C12.1, IN2.2
IN-L3: C13.1, IN3.2
IN-L4: C14.1, IN4.2
IN-R1: C10.1, IN1.3
IN-R2: C9.1, IN2.3
IN-R3: C8.1, IN3.3
IN-R4: C7.1, IN4.3
MO-L: IC4.8, MIX-OUT.1
MO-R: IC4.9, MIX-OUT.3
unnamed: C25.+, IC4.23
unnamed: C8.2, IC4.1
unnamed: C13.2, IC4.6
unnamed: C14.2, IC4.7
unnamed: C12.2, IC4.5
unnamed: C11.2, IC4.4
unnamed: C10.2, IC4.3
unnamed: C9.2, IC4.2
unnamed: C22.1, IC4.18
unnamed: C21.1, IC4.19
unnamed: C15.1, IC4.10
unnamed: C16.1, IC4.11
unnamed: C7.2, IC4.28
unnamed: C15.2, C16.2, R5.2
unnamed: C17.1, IC4.12
unnamed: C18.1, IC4.13
unnamed: C17.2, C18.2, R6.2
unnamed: C24.1, IC4.16
unnamed: C23.1, IC4.17
unnamed: C23.2, C24.2, R8.2
unnamed: C19.1, IC4.14
unnamed: C20.1, IC4.15
unnamed: C19.2, C20.2, R7.2
OU-L: IC4.27, OUTL.1
OU-R: IC4.26, OUTR.1
SCL: I2C.3, IC4.21
SDA: I2C.5, IC4.22

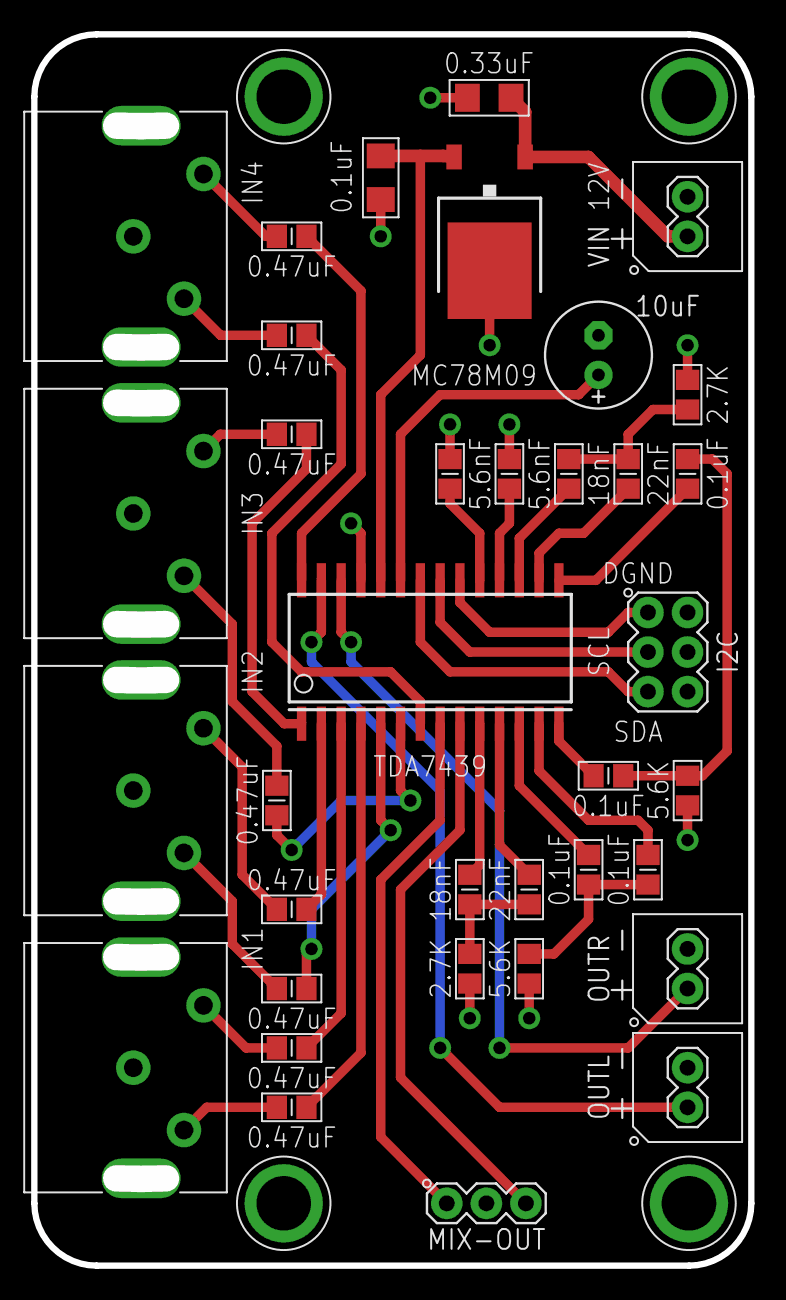
[picture p38: board module-pre-amp.brd from above]

Board: 2 copper layers, 46.0 x 79.0 mm, 40 parts (0 on the bottom side), 41 nets.
