mkulesh/digitalAmplifier/pcb/module-mp7740.brd

## EAGLE design pcb/module-mp7740.brd (2021-05-24)

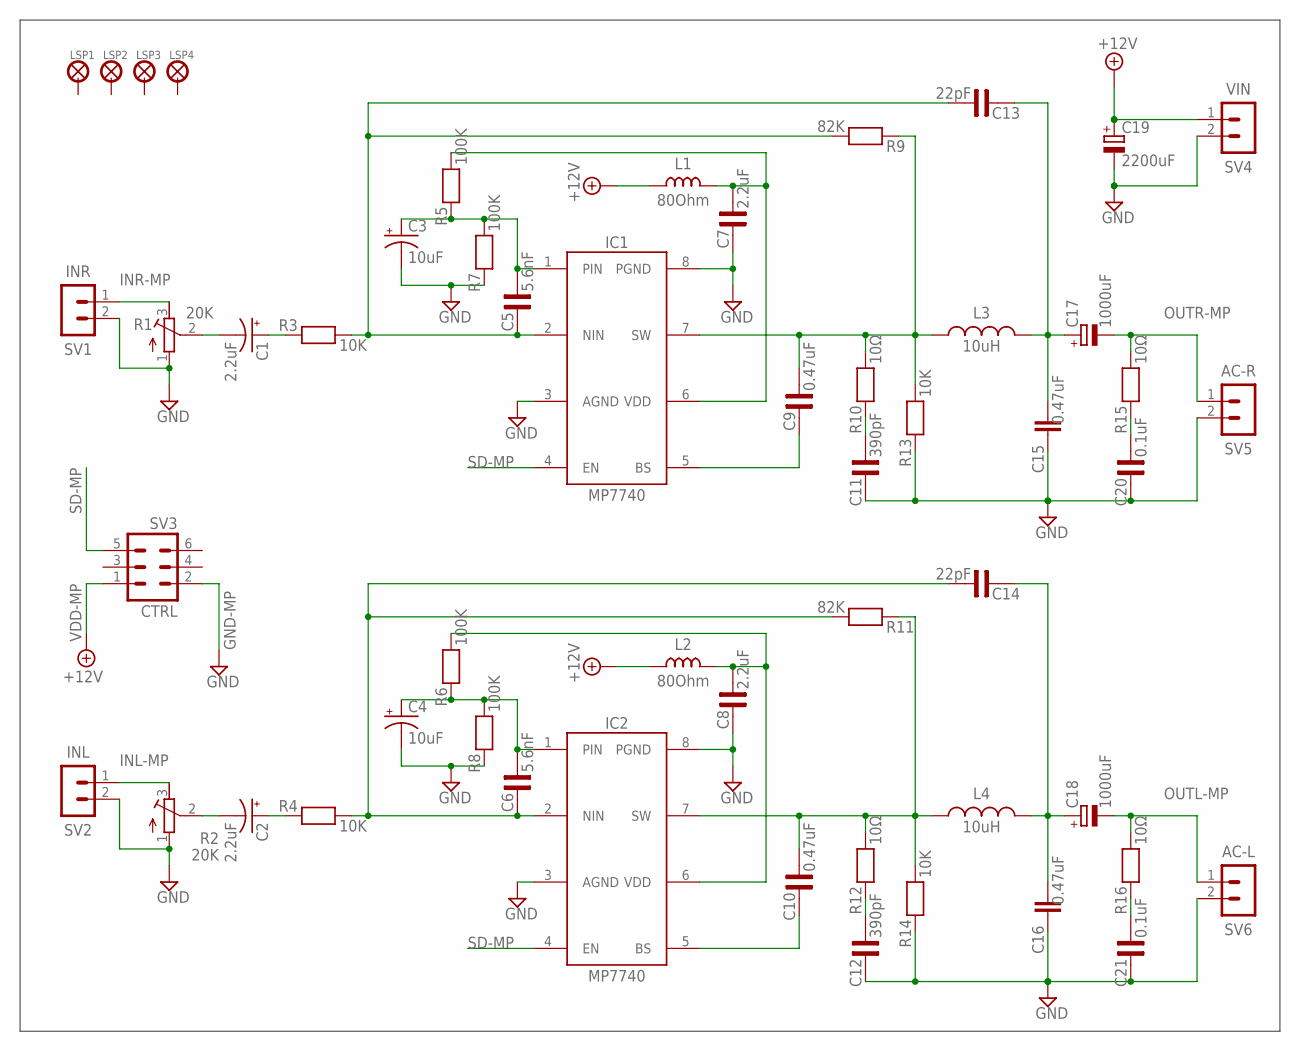
[picture p39: schematic module-mp7740.sch]

Parts:
C1, C2: 2.2uF; E2-5
C3, C4: 10uF; E2-5
C5, C6: 5.6nF; C0805
C7, C8: 2.2uF; C1206
C9, C10: 0.47uF; C0805
C11, C12: 390pF; C0805
C13, C14: 22pF; C0805
C15, C16: 0.47uF; C050-050X075
C17, C18: 1000uF; E5-13
C19: 2200uF; E7,5-16
C20, C21: 0.1uF; C0805
IC1, IC2: MP7740; SOIC-8
L1, L2: 80Ohm; L0805
L3, L4: 10uH; 6000-XXXX-RC
LSP1, LSP2, LSP3, LSP4: LSP27
R1, R2: 20K; PV32H
R3, R4, R13, R14: 10K; R0805
R5, R6, R7, R8: 100K; R0805
R9, R11: 82K; R0805
R10, R12, R15, R16: 10Ω; R0805
SV1: INR; MA02-1-GREEN
SV2: INL; MA02-1-GREEN
SV3: CTRL; MA03-2
SV4: VIN; MA02-1-GREEN
SV5: AC-R; MA02-1-GREEN
SV6: AC-L; MA02-1-GREEN

Connections:
GND-MP: C3.-, C4.-, C7.1, C8.1, C11.1, C12.1, C15.1, C16.1, C19.-, C20.1, C21.1, IC1.3 (AGND), IC1.8 (PGND), IC2.3 (AGND), IC2.8 (PGND), R1.1, R2.1, R7.1, R8.1, R13.1, R14.1, SV1.2, SV2.2, SV3.2, SV4.2, SV5.2, SV6.2
INL-MP: R2.3, SV2.1
INR-MP: R1.3, SV1.1
unnamed: C5.1, C13.2, IC1.2 (NIN), R3.2, R9.2
unnamed: C1.+, R3.1
unnamed: C1.-, R1.2
unnamed: C9.2, IC1.7 (SW), L3.1, R9.1, R10.2, R13.2
unnamed: C9.1, IC1.5 (BS)
unnamed: C11.2, R10.1
unnamed: C13.1, C15.2, C17.+, L3.2
unnamed: C20.2, R15.1
unnamed: C6.1, C14.2, IC2.2 (NIN), R4.2, R11.2
unnamed: C3.+, C5.2, IC1.1 (PIN), R5.1, R7.2
unnamed: C2.+, R4.1
unnamed: C10.2, IC2.7 (SW), L4.1, R11.1, R12.2, R14.2
unnamed: C10.1, IC2.5 (BS)
unnamed: C12.2, R12.1
unnamed: C14.1, C16.2, C18.+, L4.2
unnamed: C21.2, R16.1
unnamed: C4.+, C6.2, IC2.1 (PIN), R6.1, R8.2
unnamed: C2.-, R2.2
OUTL-MP: C18.-, R16.2, SV6.1
OUTR-MP: C17.-, R15.2, SV5.1
SD-MP: IC1.4 (EN), IC2.4 (EN), SV3.5
VCCL: C8.2, IC2.6 (VDD), L2.2, R6.2
VCCR: C7.2, IC1.6 (VDD), L1.2, R5.2
VDD-MP: C19.+, L1.1, L2.1, SV3.1, SV4.1

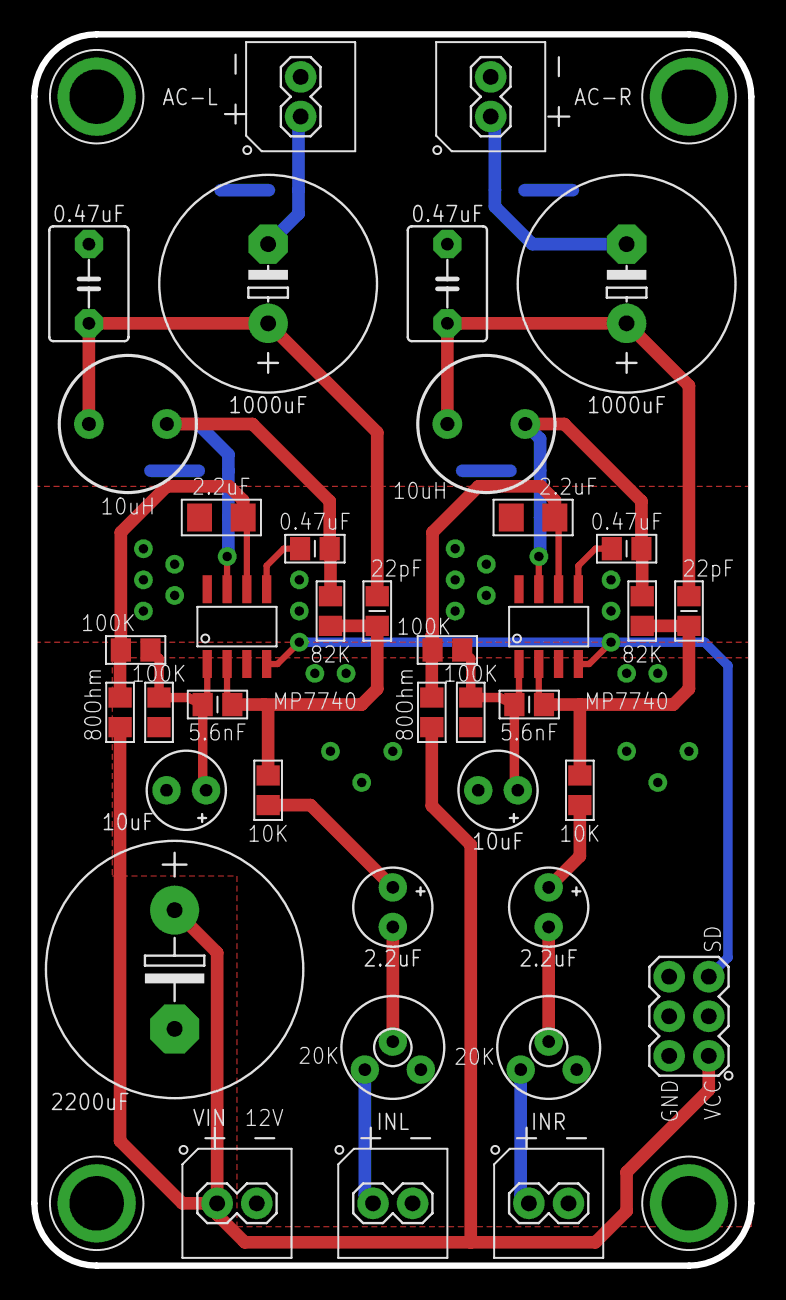
[picture p40: board module-mp7740.brd from above]

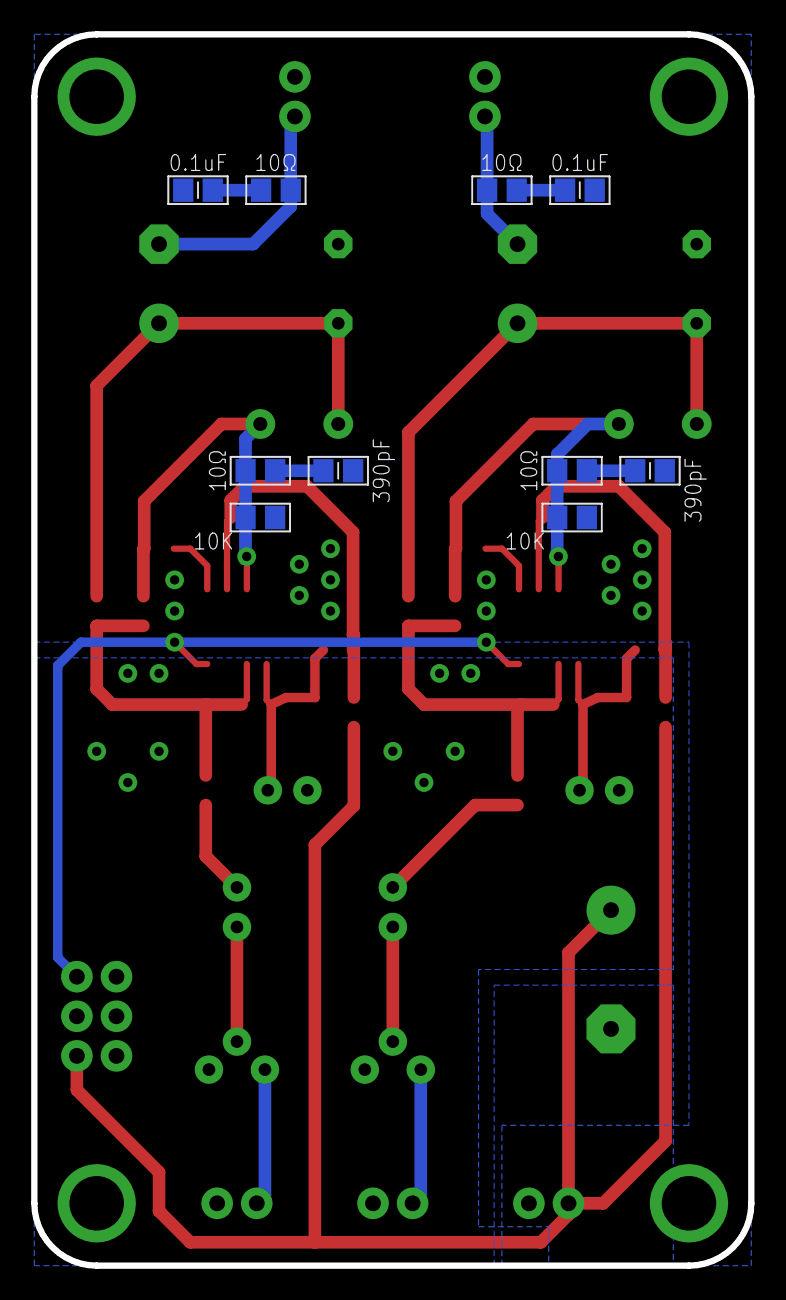
[picture p41: board module-mp7740.brd from below]

Board: 2 copper layers, 46.0 x 79.0 mm, 53 parts (10 on the bottom side), 27 nets.
