mkulesh/digitalAmplifier/pcb/module-mcu.brd

## EAGLE design pcb/module-mcu.brd (2021-05-24)

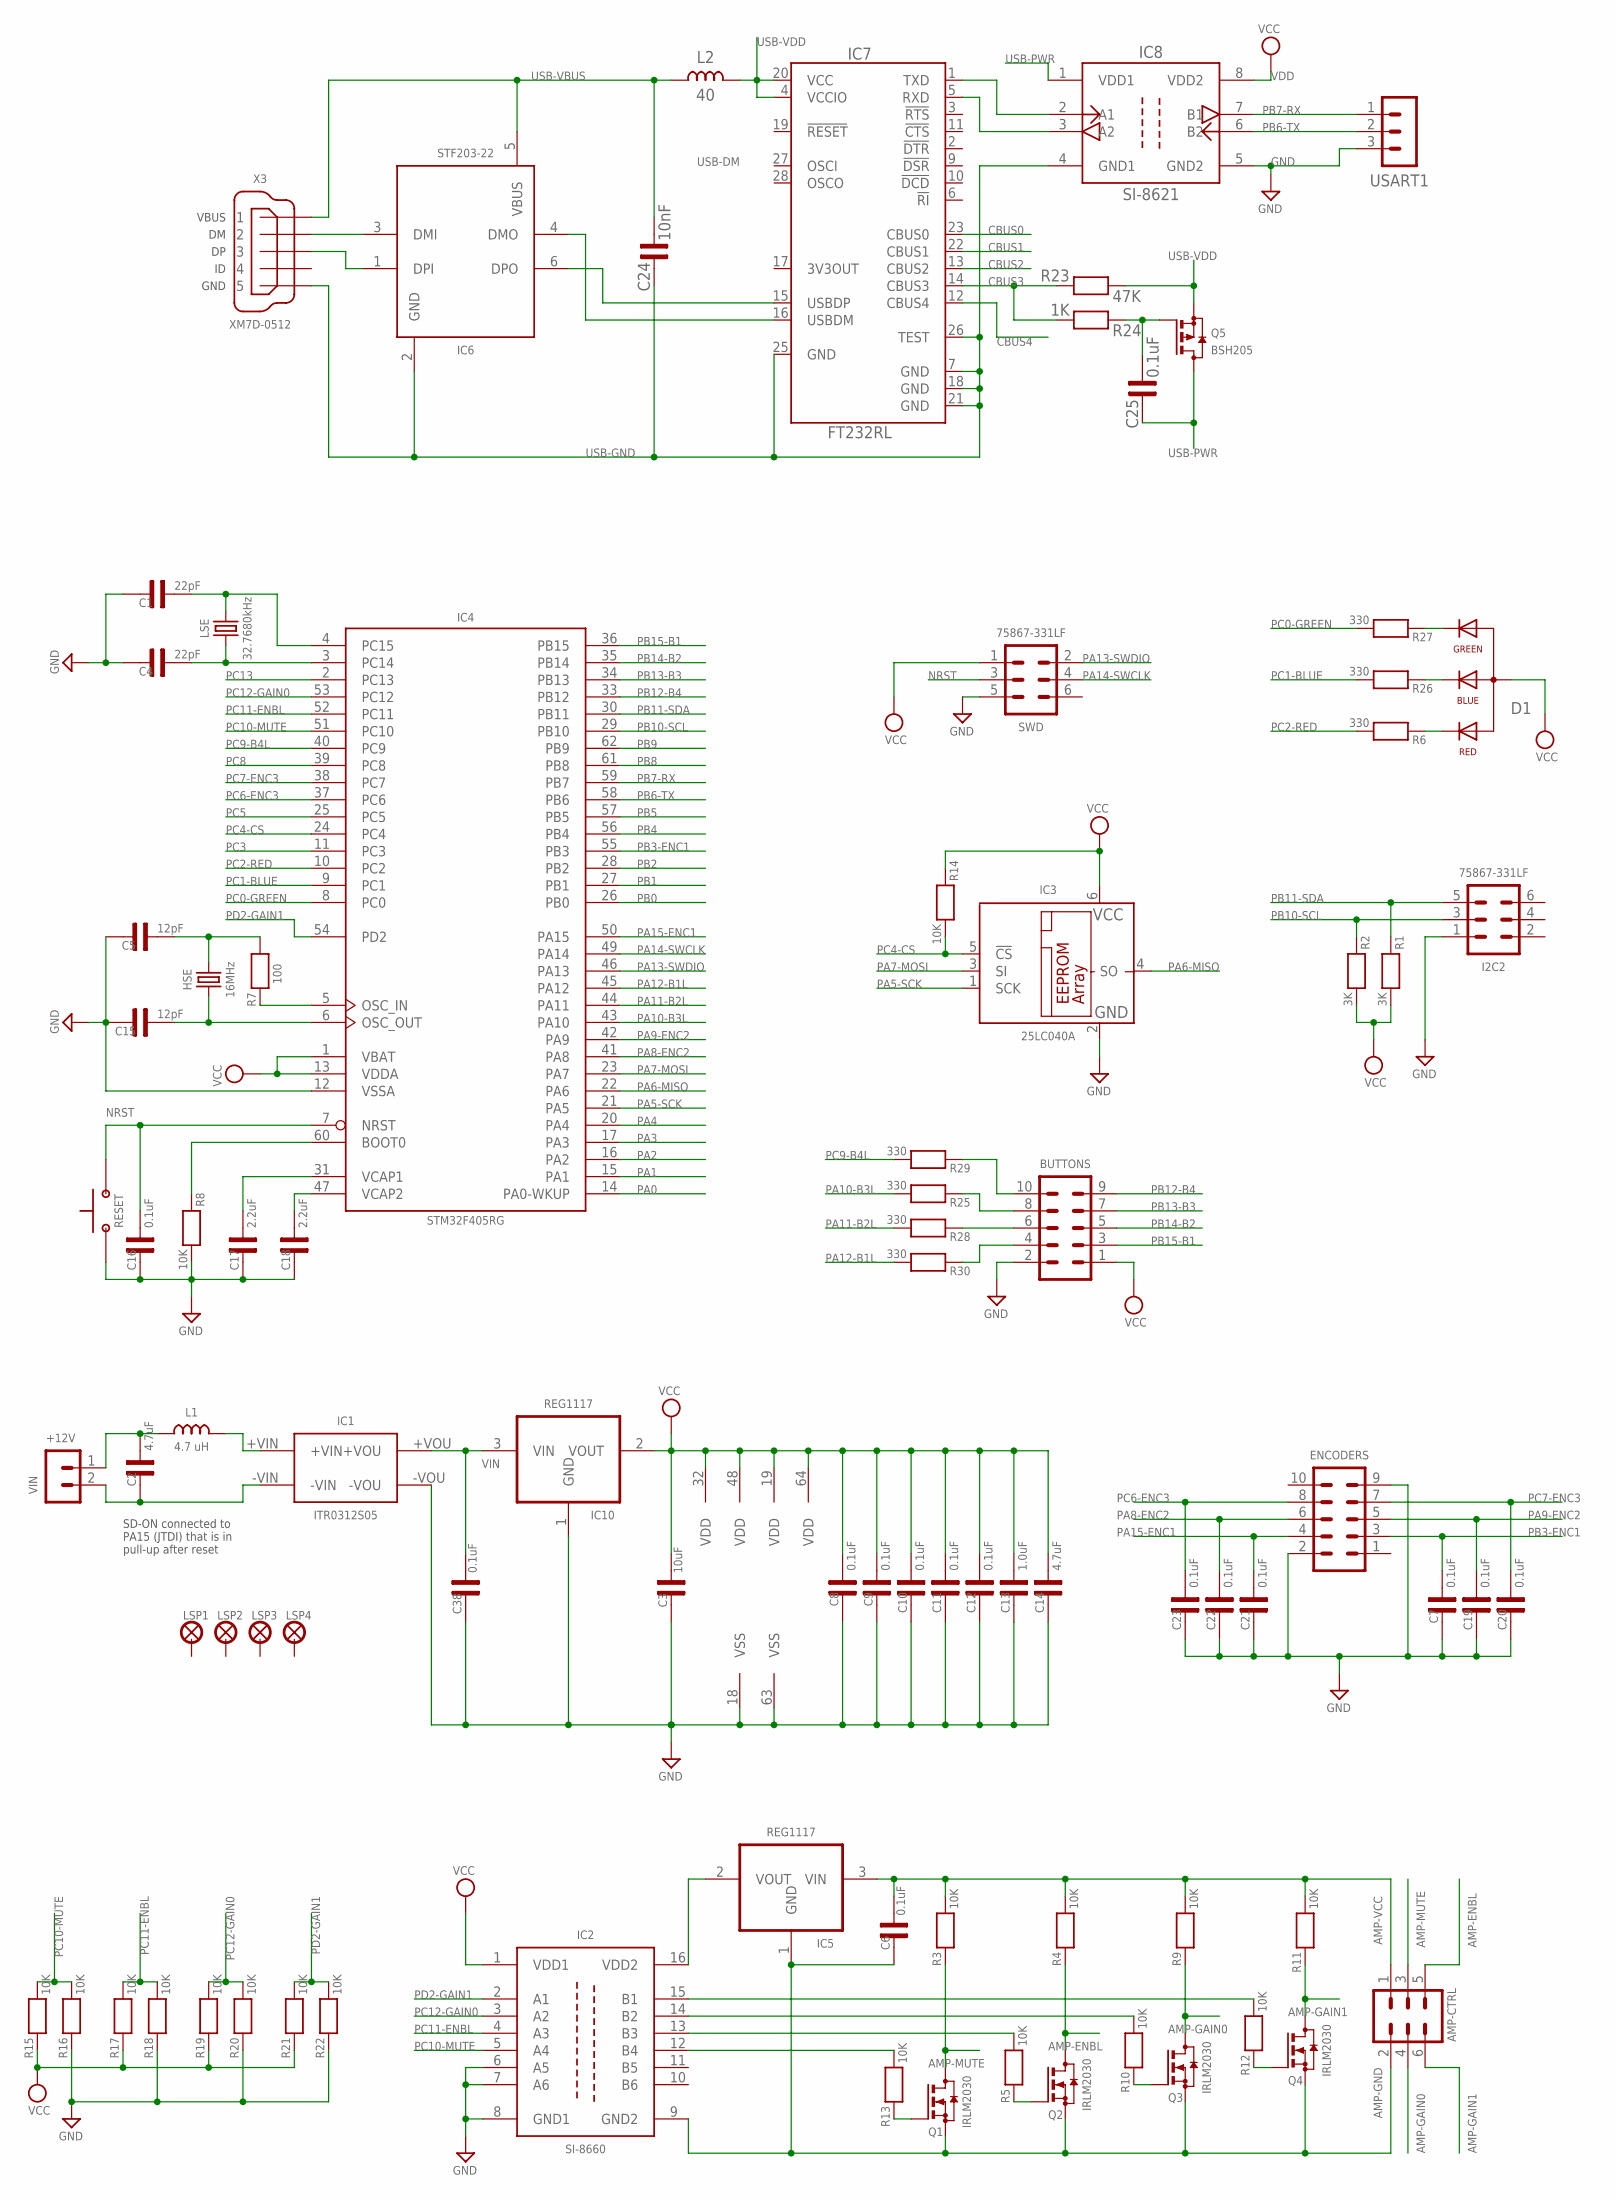
[picture p42: schematic module-mcu.sch, STM32-Pi Board]

Parts:
AMP-CTRL: MA03-2PL; MA03-2
BUTTONS: MA05-2
C1, C4: 22pF; C0805
C2: 4.7uF; C1206
C3: 10uF; C0805
C5, C15: 12pF; C0805
C6, C7, C8, C9, C10, C11, C12, C16, C19, C20, C21, C22, C23, C25, C38: 0.1uF; C0805
C13: 1.0uF; C0805
C14: 4.7uF; C0805
C17, C18: 2.2uF; C0805
C24: 10nF; C0805
D1: RGB-LED3X1MM; RGB-LED-SMD-3X1
ENCODERS: MA05-2
HSE: 16MHz; Q-HC-46X
I2C2: 75867-331LF; MA03-2
IC1: ITR0312S05
IC2: SI-8660; SO16
IC3: 25LC040A; SOT23-6
IC4: STM32F405RG; LQFP64
IC5, IC10: REG1117; SOT223
IC6: STF203-22; SC70-6
IC7: FT232RL; SSOP28
IC8: SI-8621; SOIC-8
L1: 4.7 uH; L0805
L2: 40; L0805
LSE: 32.7680kHz; Q-CM7V-T1A
LSP1, LSP2, LSP3, LSP4: LSP27
Q1, Q2, Q3, Q4: IRLM2030; SOT23
Q5: BSH205; SOT23
R1, R2: 3K; R0805
R3, R4, R5, R8, R9, R10, R11, R12, R13, R14, R15, R16, R17, R18, R19, R20, R21, R22: 10K; R0805
R6, R25, R26, R27, R28, R29, R30: 330; R0805
R7: 100; R0805
R23: 47K; R0805
R24: 1K; R0805
RESET: BUTTON-FSM14JRT
SWD: 75867-331LF; MA03-2-BLUE
USART1: MA03-1PL; MA03-1
VIN: MA02-1GREEN; MA02-1-GREEN
X3: XM7D-0512

Connections:
AMP-ENBL: AMP-CTRL.5, Q2.3 (D), R4.1
AMP-GAIN0: AMP-CTRL.4, Q3.3 (D), R9.1
AMP-GAIN1: AMP-CTRL.6, Q4.3 (D), R11.1
AMP-GND: AMP-CTRL.2, C6.1, IC2.9 (GND2), IC5.1 (GND), Q1.2 (S), Q2.2 (S), Q3.2 (S), Q4.2 (S)
AMP-MUTE: AMP-CTRL.3, Q1.3 (D), R3.1
AMP-VCC: AMP-CTRL.1, C6.2, IC5.3 (VIN), R3.2, R4.2, R9.2, R11.2
BOOT: IC4.60 (BOOT0), R8.1
CBUS0: IC7.23 (CBUS0)
CBUS1: IC7.22 (CBUS1)
CBUS2: IC7.13 (CBUS2)
CBUS3: IC7.14 (CBUS3), R23.1, R24.2
CBUS4: IC7.12 (CBUS4)
GND: BUTTONS.2, C1.1, C3.1, C4.1, C5.1, C7.1, C8.1, C9.1, C10.1, C11.1, C12.1, C13.1, C14.1, C15.1, C16.1, C17.1, C18.1, C19.1, C20.1, C21.1, C22.1, C23.1, C38.1, ENCODERS.2, ENCODERS.9, I2C2.1, IC1.-VOU, IC2.6 (A5), IC2.7 (A6), IC2.8 (GND1), IC3.2 (GND), IC4.12 (VSSA), IC4.18 (VSS), IC4.63 (VSS), IC8.5 (GND2), IC10.1 (GND), R8.2, R16.1, R18.1, R20.1, R22.1, RESET.P$1 (1), SWD.5, USART1.3
unnamed: C2.1, IC1.-VIN, VIN.2
unnamed: D1.P$1 (AR), R6.1
unnamed: IC4.5 (OSC_IN), R7.1
unnamed: IC1.+VIN, L1.2
unnamed: C2.2, L1.1, VIN.1
unnamed: Q2.1 (G), R5.1
unnamed: Q1.1 (G), R13.1
unnamed: IC2.12 (B4), R13.2
unnamed: IC2.13 (B3), R5.2
unnamed: Q3.1 (G), R10.1
unnamed: IC2.14 (B2), R10.2
unnamed: Q4.1 (G), R12.1
unnamed: IC2.15 (B1), R12.2
unnamed: IC2.16 (VDD2), IC5.2 (VOUT)
unnamed: IC6.1 (DPI), X3.3
unnamed: D1.P$4 (AB), R26.1
unnamed: IC6.3 (DMI), X3.2
unnamed: IC7.1 (TXD), IC8.2 (A1)
unnamed: IC7.5 (RXD), IC8.3 (A2)
unnamed: C25.2, Q5.1 (G), R24.1
unnamed: BUTTONS.4, R30.1
unnamed: BUTTONS.6, R28.1
unnamed: BUTTONS.8, R25.1
unnamed: BUTTONS.10, R29.1
unnamed: C5.2, HSE.1, R7.2
unnamed: D1.P$3 (AG), R27.1
unnamed: C15.2, HSE.2, IC4.6 (OSC_OUT)
NRST: C16.2, IC4.7 (NRST), RESET.P$2 (2), SWD.3
PA0: IC4.14 (PA0-WKUP)
PA1: IC4.15 (PA1)
PA2: IC4.16 (PA2)
PA3: IC4.17 (PA3)
PA4: IC4.20 (PA4)
PA5-SCK: IC3.1 (SCK), IC4.21 (PA5)
PA6-MISO: IC3.4 (SO), IC4.22 (PA6)
PA7-MOSI: IC3.3 (SI), IC4.23 (PA7)
PA8-ENC2: C22.2, ENCODERS.6, IC4.41 (PA8)
PA9-ENC2: C19.2, ENCODERS.5, IC4.42 (PA9)
PA10-B3L: IC4.43 (PA10), R25.2
PA11-B2L: IC4.44 (PA11), R28.2
PA12-B1L: IC4.45 (PA12), R30.2
PA13-SWDIO: IC4.46 (PA13), SWD.2
PA14-SWCLK: IC4.49 (PA14), SWD.4
PA15-ENC1: C21.2, ENCODERS.4, IC4.50 (PA15)
PB0: IC4.26 (PB0)
PB1: IC4.27 (PB1)
PB2: IC4.28 (PB2)
PB3-ENC1: C7.2, ENCODERS.3, IC4.55 (PB3)
PB4: IC4.56 (PB4)
PB5: IC4.57 (PB5)
PB6-TX: IC4.58 (PB6), IC8.6 (B2), USART1.2
PB7-RX: IC4.59 (PB7), IC8.7 (B1), USART1.1
PB8: IC4.61 (PB8)
PB9: IC4.62 (PB9)
PB10-SCL: I2C2.3, IC4.29 (PB10), R2.1
PB11-SDA: I2C2.5, IC4.30 (PB11), R1.1
PB12-B4: BUTTONS.9, IC4.33 (PB12)
PB13-B3: BUTTONS.7, IC4.34 (PB13)
PB14-B2: BUTTONS.5, IC4.35 (PB14)
PB15-B1: BUTTONS.3, IC4.36 (PB15)
PC0-GREEN: IC4.8 (PC0), R27.2
PC1-BLUE: IC4.9 (PC1), R26.2
PC2-RED: IC4.10 (PC2), R6.2
PC3: IC4.11 (PC3)
PC4-CS: IC3.5 (!CS), IC4.24 (PC4), R14.2
PC5: IC4.25 (PC5)
PC6-ENC3: C23.2, ENCODERS.8, IC4.37 (PC6)
PC7-ENC3: C20.2, ENCODERS.7, IC4.38 (PC7)
PC8: IC4.39 (PC8)
PC9-B4L: IC4.40 (PC9), R29.2
PC10-MUTE: IC2.5 (A4), IC4.51 (PC10), R15.2, R16.2
PC11-ENBL: IC2.4 (A3), IC4.52 (PC11), R17.2, R18.2
PC12-GAIN0: IC2.3 (A2), IC4.53 (PC12), R19.2, R20.2
PC13: IC4.2 (PC13)
PD2-GAIN1: IC2.2 (A1), IC4.54 (PD2), R21.2, R22.2
Q2M: C4.2, IC4.3 (PC14), LSE.1
Q2P: C1.2, IC4.4 (PC15), LSE.2
USB-DM: IC6.4 (DMO), IC7.16 (USBDM)
USB-DP: IC6.6 (DPO), IC7.15 (USBDP)
USB-GND: C24.1, IC6.2 (GND), IC7.7 (GND), IC7.18 (GND), IC7.21 (GND), IC7.25 (GND), IC7.26 (TEST), IC8.4 (GND1), X3.5
USB-PWR: C25.1, IC8.1 (VDD1), Q5.3 (D)
USB-VBUS: C24.2, IC6.5 (VBUS), L2.1, X3.1
USB-VDD: IC7.4 (VCCIO), IC7.20 (VCC), L2.2, Q5.2 (S), R23.2
VCAP3: C18.2, IC4.47 (VCAP2)
VCAP4: C17.2, IC4.31 (VCAP1)
VDD: BUTTONS.1, C3.2, C8.2, C9.2, C10.2, C11.2, C12.2, C13.2, C14.2, D1.P$2 (C), IC2.1 (VDD1), IC3.6 (VCC), IC4.1 (VBAT), IC4.13 (VDDA), IC4.19 (VDD), IC4.32 (VDD), IC4.48 (VDD), IC4.64 (VDD), IC8.8 (VDD2), IC10.2 (VOUT), R1.2, R2.2, R14.1, R15.1, R17.1, R19.1, R21.1, SWD.1
VIN: C38.2, IC1.+VOU, IC10.3 (VIN)

Notes on the sheet:
SD-ON connected to PA15 (JTDI) that is in pull-up after reset

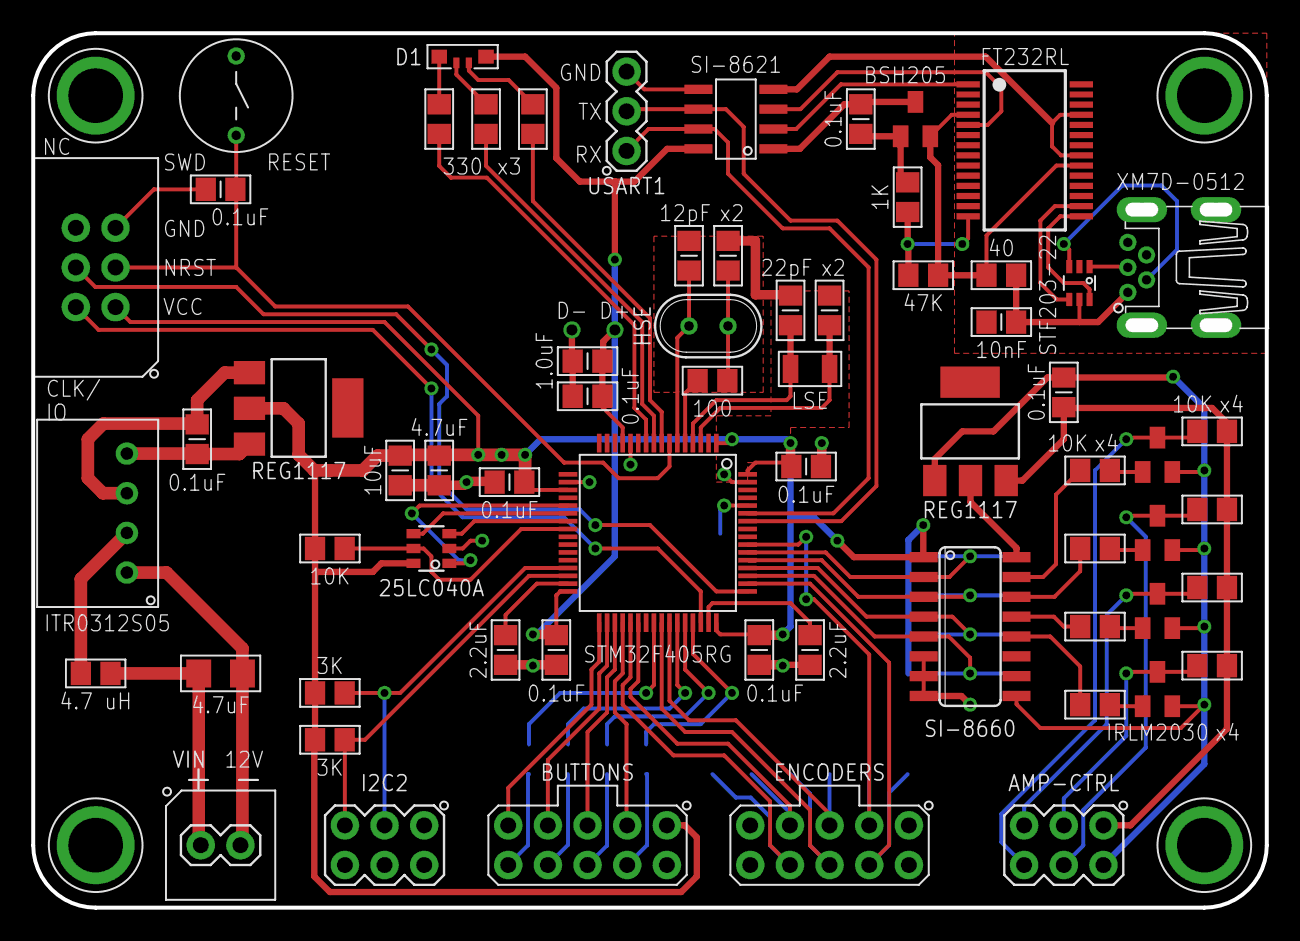
[picture p43: board module-mcu.brd from above]

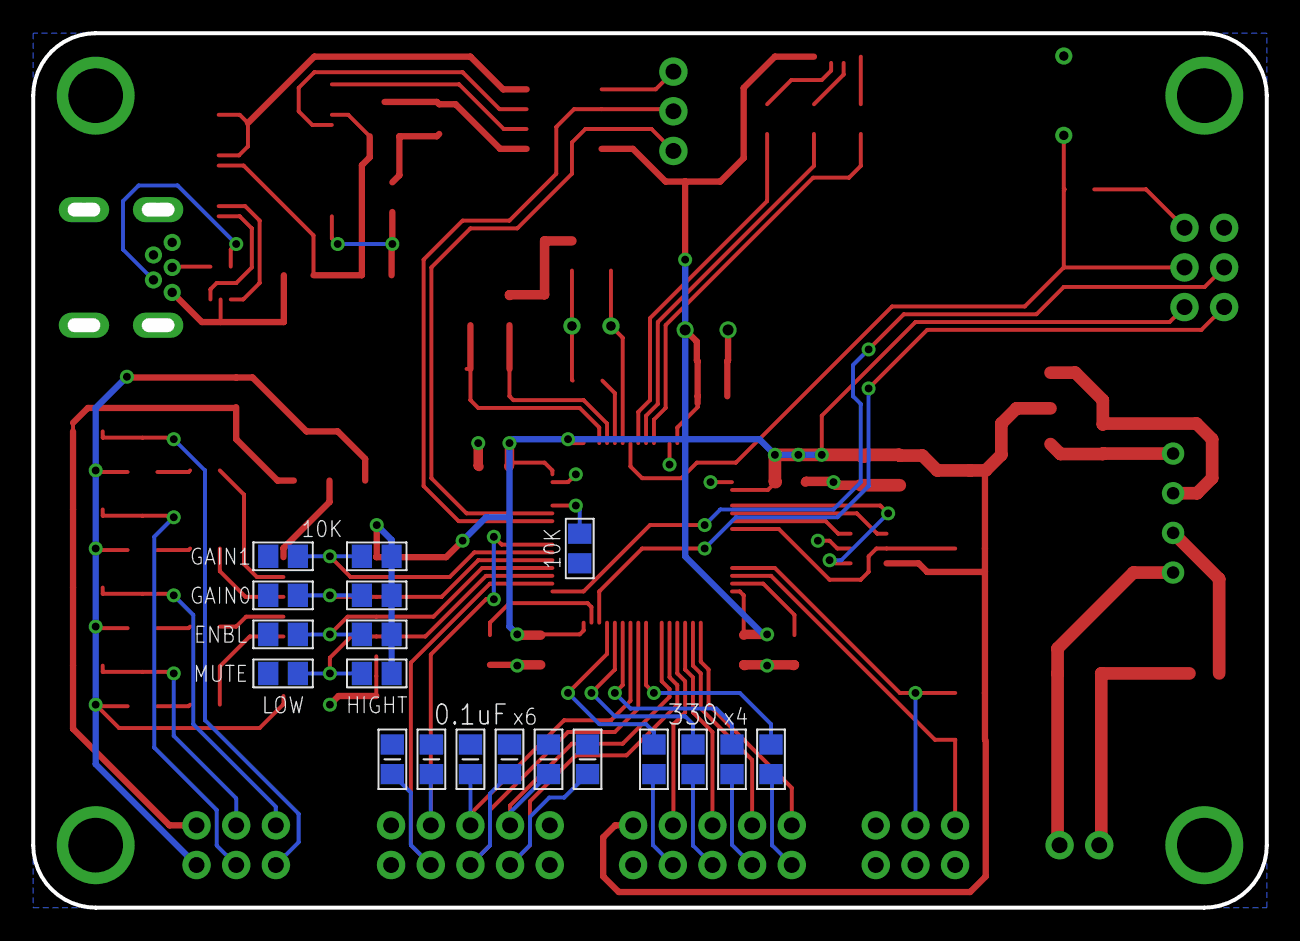
[picture p44: board module-mcu.brd from below]

Board: 2 copper layers, 79.0 x 56.0 mm, 88 parts (19 on the bottom side), 80 nets.
