mkulesh/digitalAmplifier/pcb/module-encoders.brd

## EAGLE design pcb/module-encoders.brd (2021-05-24)

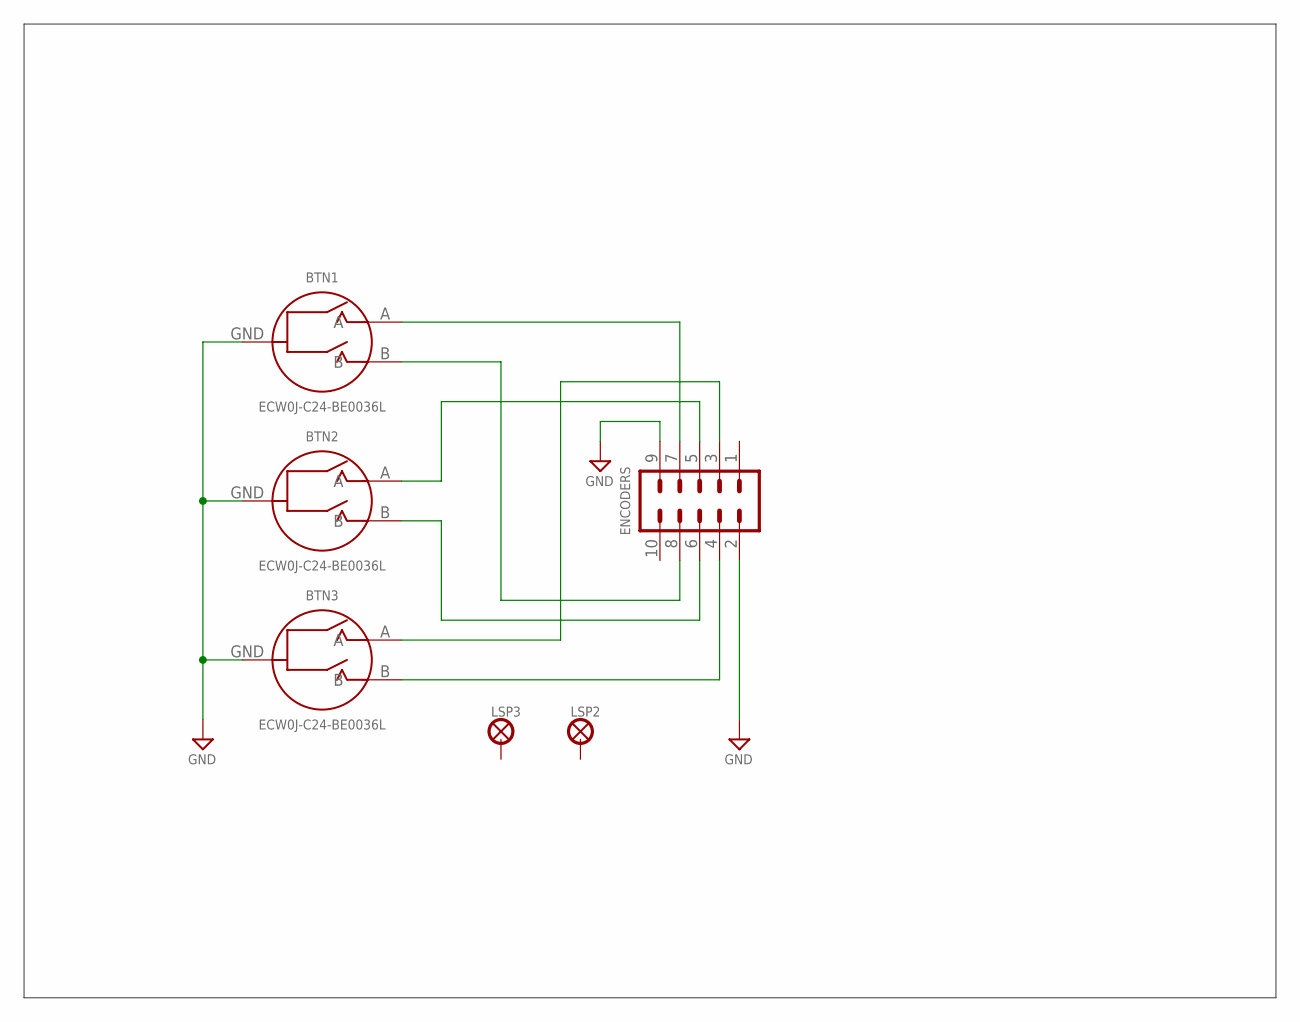
[picture p45: schematic module-encoders.sch]

Parts:
BTN1, BTN2, BTN3: ECW0J-C24-BE0036L; ECW0J-C24
ENCODERS: MA05-2
LSP2, LSP3: LSP27

Connections:
GND: BTN1.GND, BTN2.GND, BTN3.GND, ENCODERS.2, ENCODERS.9
unnamed: BTN3.B, ENCODERS.4
unnamed: BTN2.B, ENCODERS.6
unnamed: BTN1.B, ENCODERS.8
unnamed: BTN2.A, ENCODERS.5
unnamed: BTN1.A, ENCODERS.7
unnamed: BTN3.A, ENCODERS.3

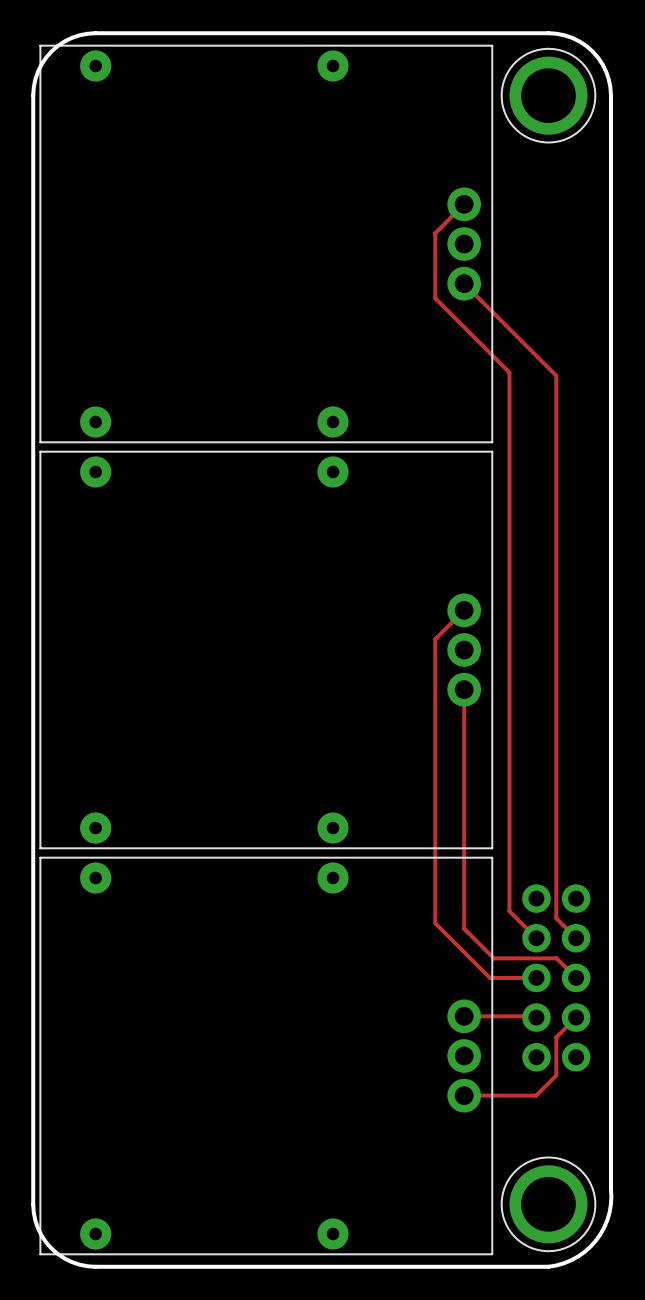
[picture p46: board module-encoders.brd from above]

Board: 2 copper layers, 37.0 x 79.0 mm, 6 parts (1 on the bottom side), 7 nets.
