mkulesh/digitalAmplifier/pcb/module-buttons.brd

## EAGLE design pcb/module-buttons.brd (2021-05-24)

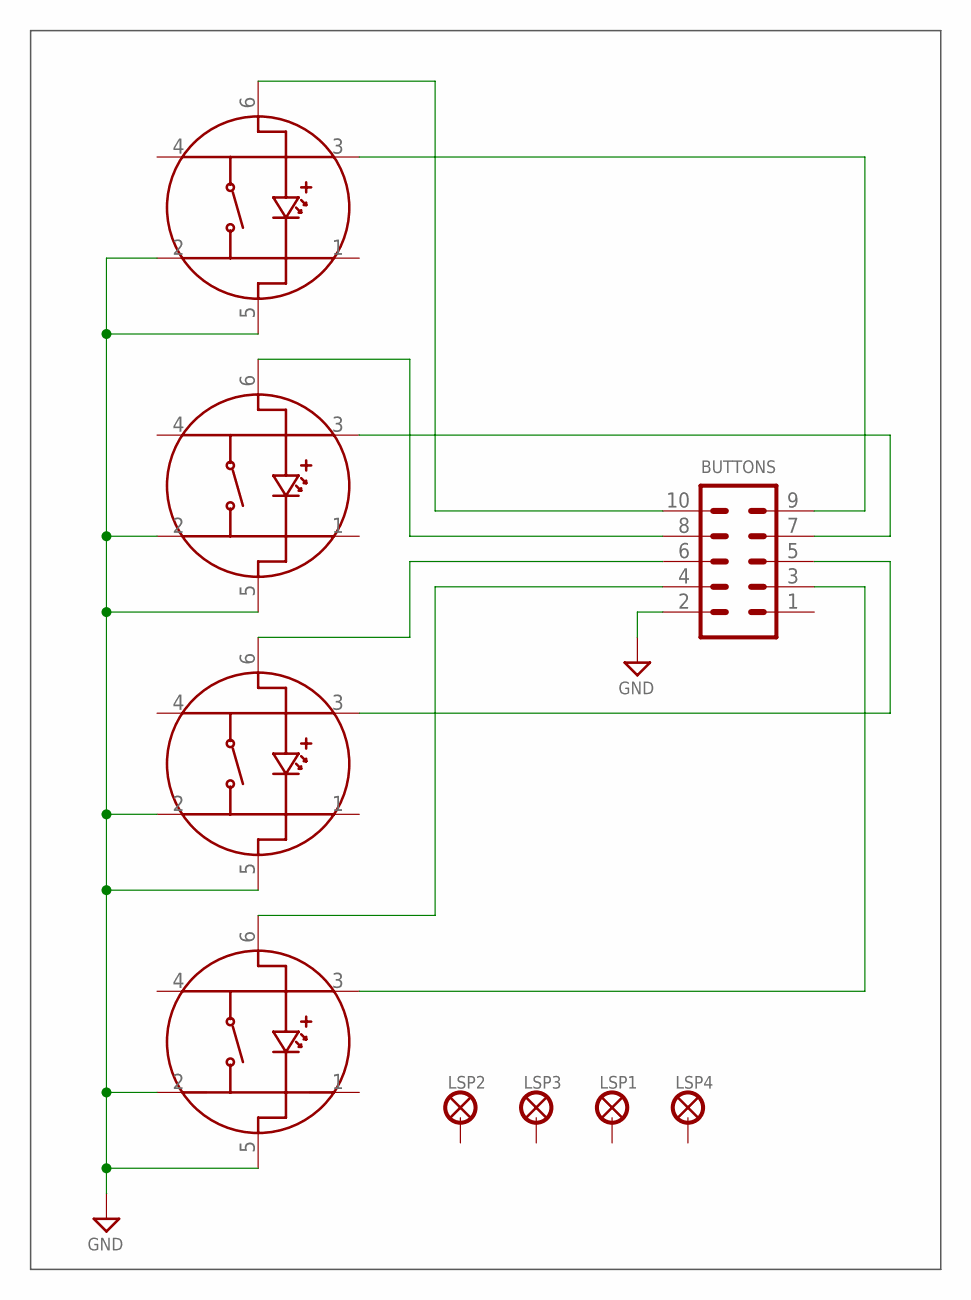
[picture p47: schematic module-buttons.sch]

Parts:
BTN1, BTN2, BTN3, BTN4: BUTTON-TL1265
BUTTONS: MA05-2
LSP1, LSP2, LSP3, LSP4: LSP27

Connections:
GND: BTN1.2, BTN1.5, BTN2.2, BTN2.5, BTN3.2, BTN3.5, BTN4.2, BTN4.5, BUTTONS.2
unnamed: BTN3.6, BUTTONS.6
unnamed: BTN2.3, BUTTONS.7
unnamed: BTN1.3, BUTTONS.9
unnamed: BTN3.3, BUTTONS.5
unnamed: BTN4.3, BUTTONS.3
unnamed: BTN4.6, BUTTONS.4
unnamed: BTN2.6, BUTTONS.8
unnamed: BTN1.6, BUTTONS.10

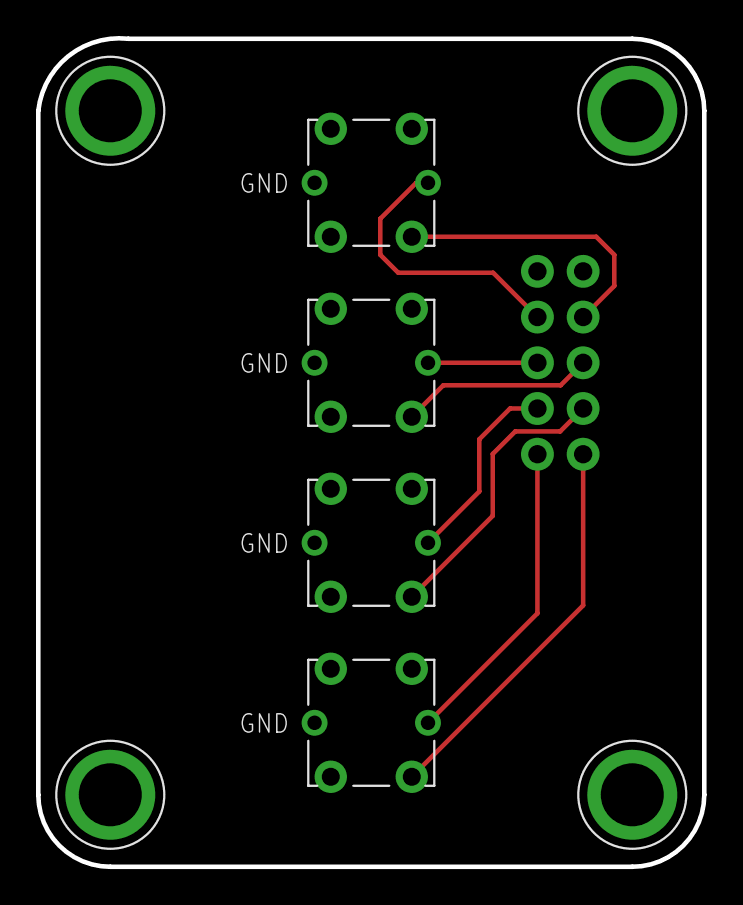
[picture p48: board module-buttons.brd from above]

Board: 2 copper layers, 37.0 x 46.0 mm, 9 parts (1 on the bottom side), 9 nets.
