mkulesh/digitalAmplifier/src/src/main.cpp

/*******************************************************************************
 * Digital Amplifier based on STM32F405RGT6
 * *****************************************************************************
 * Copyright (C) 2021 Mikhail Kulesh
 *
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
 * You should have received a copy of the GNU General Public License
 * along with this program.  If not, see <http://www.gnu.org/licenses/>.
 ******************************************************************************/

#include "MyApplication.h"

MyApplication * appPtr = NULL;

int main (void)
{
    // Note: check the Value of the External oscillator mounted in PCB
    // and set this value in the file stm32f4xx_hal_conf.h
    HAL_Init();

    __HAL_PWR_VOLTAGESCALING_CONFIG(PWR_REGULATOR_VOLTAGE_SCALE1);
    /* STM32F405x/407x/415x/417x Revision Z devices: prefetch is supported  */
    if (HAL_GetREVID() == 0x1001)
    {
        /* Enable the Flash prefetch */
        __HAL_FLASH_PREFETCH_BUFFER_ENABLE();
    }

    MyApplication app;
    appPtr = &app;

    // Note: currently used EEPROM only works with core frequency 72MHz or below
    app.run(72);
}
