mkulesh/digitalAmplifier/cubeMX/digitalAmplifier.ioc

Mcu.UserName=STM32F405RGTx
PA10.GPIO_Label=btn3Led
PA10.Signal=GPIO_Output
PA11.GPIO_Label=btn2Led
PA11.Signal=GPIO_Output
PA12.GPIO_Label=btn1Led
PA12.Signal=GPIO_Output
PA13.Signal=SYS_JTMS-SWDIO
PA14.Signal=SYS_JTCK-SWCLK
PA15.GPIO_Label=enc1ch1
PA15.Signal=S_TIM2_CH1_ETR
PA2.Signal=USART2_TX
PA3.Signal=USART2_RX
PA5.Signal=SPI1_SCK
PA6.Signal=SPI1_MISO
PA7.Signal=SPI1_MOSI
PA8.GPIO_Label=enc2ch1
PA8.Signal=S_TIM1_CH1
PA9.GPIO_Label=enc2ch2
PA9.Signal=S_TIM1_CH2
PB10.Signal=I2C2_SCL
PB11.Signal=I2C2_SDA
PB12.GPIO_Label=btn4
PB12.Signal=GPIO_Input
PB13.GPIO_Label=btn3
PB13.Signal=GPIO_Input
PB14.GPIO_Label=btn2
PB14.Signal=GPIO_Input
PB15.GPIO_Label=btn1
PB15.Signal=GPIO_Input
PB3.GPIO_Label=enc1ch2
PB3.Signal=S_TIM2_CH2
PB6.Signal=USART1_TX
PB7.Signal=USART1_RX
PB8.Signal=I2C1_SCL
PB9.Signal=I2C1_SDA
PC0.GPIO_Label=ledGreen
PC0.Signal=GPIO_Output
PC1.GPIO_Label=ledBlue
PC1.Signal=GPIO_Output
PC10.GPIO_Label=ampMute
PC10.Signal=GPIO_Input
PC11.GPIO_Label=ampEnable
PC11.Signal=GPIO_Output
PC12.GPIO_Label=ampGain0
PC12.Signal=GPIO_Output
PC14-OSC32_IN.Signal=RCC_OSC32_IN
PC15-OSC32_OUT.Signal=RCC_OSC32_OUT
PC2.GPIO_Label=ledRed
PC2.Signal=GPIO_Output
PC4.GPIO_Label=SPI1_CS
PC4.Signal=GPIO_Output
PC6.GPIO_Label=enc3ch1
PC6.Signal=S_TIM3_CH1
PC7.GPIO_Label=enc3ch2
PC7.Signal=S_TIM3_CH2
PC9.GPIO_Label=btn4Led
PC9.Signal=GPIO_Output
PD2.GPIO_Label=ampGain1
PD2.Signal=GPIO_Output
PH0-OSC_IN.Signal=RCC_OSC_IN
PH1-OSC_OUT.Signal=RCC_OSC_OUT
