mkulesh/digitalAmplifier/src/src/stm32async/Timer.h

/*******************************************************************************
 * stm32async: Asynchronous I/O C++ library for STM32
 * *****************************************************************************
 * Copyright (C) 2018 Mikhail Kulesh, Denis Makarov
 *
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
 * You should have received a copy of the GNU General Public License
 * along with this program.  If not, see <http://www.gnu.org/licenses/>.
 ******************************************************************************/

#ifndef STM32ASYNC_TIMER_H_
#define STM32ASYNC_TIMER_H_

#include "HardwareLayout/Timer.h"

#ifdef HAL_TIM_MODULE_ENABLED

#include "IODevice.h"

namespace Stm32async
{

/**
 * @brief Class that implements basic timer interface.
 */
class BaseTimer
{
public:

    /**
     * @brief Default constructor.
     */
    BaseTimer (const HardwareLayout::Timer & _device);

    DeviceStart::Status startCounter (uint32_t counterMode, uint32_t prescaler, uint32_t period,
                                      uint32_t clockDivision = TIM_CLOCKDIVISION_DIV1);

    void stopCounter ();

    /**
     * @brief Returns device ID.
     */
    inline size_t getId () const
    {
        return device.getId();
    }

    inline TIM_HandleTypeDef & getParameters ()
    {
        return parameters;
    }

    /**
     * @brief Getter for HAL status of the last operation
     */
    inline HAL_StatusTypeDef getHalStatus () const
    {
        return halStatus;
    }

    inline uint32_t getValue () const
    {
        return __HAL_TIM_GET_COUNTER(&parameters);
    }

    inline void reset ()
    {
        __HAL_TIM_SET_COUNTER(&parameters, 0);
    }

protected:

    const HardwareLayout::Timer & device;
    TIM_HandleTypeDef parameters;
    HAL_StatusTypeDef halStatus;
};

/**
 * @brief Class that implements timer interface.
 */
class InterruptTimer : public BaseTimer
{
public:

    /**
     * @brief Default constructor.
     */
    InterruptTimer (const HardwareLayout::Timer & _device);

    DeviceStart::Status start (uint32_t counterMode, uint32_t prescaler, uint32_t period,
                               uint32_t clockDivision = TIM_CLOCKDIVISION_DIV1,
                               uint32_t repetitionCounter = 1);

    void stop ();

    inline void setPrescaler (uint32_t prescaler)
    {
        parameters.Init.Prescaler = prescaler;
        __HAL_TIM_SET_PRESCALER(&parameters, prescaler);
    }

    inline void setPeriod (uint32_t period)
    {
        parameters.Init.Period = period;
        __HAL_TIM_SET_AUTORELOAD(&parameters, period);
    }

    inline void processInterrupt ()
    {
        HAL_TIM_IRQHandler(&parameters);
    }
};


/**
 * @brief Class that implements timer interface for the quadrature encoder
 */
class EncoderTimer : public BaseTimer
{
public:

    /**
     * @brief Default constructor.
     */
    EncoderTimer (const HardwareLayout::Timer & _device,
                  const HardwareLayout::Port & _channelAPort, uint32_t _channelAPin,
                  const HardwareLayout::Port & _channelBPort, uint32_t _channelBPin,
                  uint32_t _encoderMode, uint32_t _filter, uint32_t _prescale);

    DeviceStart::Status start (uint32_t _channel);
    void stop ();

    template <typename HANDLER>
    void periodic (HANDLER h);

private:

    IOPort channelA, channelB;
    TIM_Encoder_InitTypeDef encoder;
    uint32_t encoderVal;
};

template <typename HANDLER>
void EncoderTimer::periodic (HANDLER h)
{
    uint32_t val = getValue();
    if (encoderVal != val && abs(encoderVal - val) >= 1)
    {
        if (encoderVal == 0xFFFF && val == 0)
        {
        	h(-1);
        }
        else if (val == 0xFFFF && encoderVal == 0)
        {
        	h(1);
        }
        else
        {
        	h(encoderVal - val);
        }
        encoderVal = val;
    }
}

} // end namespace
#endif
#endif
