mkulesh/digitalAmplifier/src/src/stm32async/Spi.h

/*******************************************************************************
 * stm32async: Asynchronous I/O C++ library for STM32
 * *****************************************************************************
 * Copyright (C) 2018 Mikhail Kulesh, Denis Makarov
 *
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
 * You should have received a copy of the GNU General Public License
 * along with this program.  If not, see <http://www.gnu.org/licenses/>.
 ******************************************************************************/

#ifndef STM32ASYNC_SPI_H_
#define STM32ASYNC_SPI_H_

#include "HardwareLayout/Spi.h"

#ifdef HAL_SPI_MODULE_ENABLED

#include "IODevice.h"
#include "SharedDevice.h"

namespace Stm32async
{

/**
 * @brief Base SPI class that holds the SPI parameters and implements the communication in
 *        a blocking mode.
 */
class BaseSpi : public IODevice<HardwareLayout::Spi, SPI_HandleTypeDef, 3>
{
public:

    /**
     * @brief Default constructor.
     */
    BaseSpi (const HardwareLayout::Spi & _device, uint32_t _pull = GPIO_PULLUP);

    /**
     * @brief Open transmission session with given parameters.
     */
    DeviceStart::Status start (uint32_t direction, uint32_t prescaler,
                               uint32_t dataSize = SPI_DATASIZE_8BIT,
                               uint32_t CLKPolarity = SPI_POLARITY_HIGH,
                               uint32_t CLKPhase = SPI_PHASE_1EDGE);

    /**
     * @brief Close the transmission session.
     */
    void stop ();

    /**
     * @brief Returns pointer to the system clock pin.
     */
    inline IOPort * getSclkPin ()
    {
        return &(ports[0]);
    }

   /**
    * @brief Returns pointer to the MOSI pin.
    */
   inline IOPort * getMosiPin ()
   {
       return &(ports[1]);
   }

   /**
    * @brief Returns pointer to the MISO pin.
    */
   inline IOPort * getMisoPin ()
   {
       return &(ports[2]);
   }

    /**
     * @brief Send an amount of data in blocking mode.
     */
    inline HAL_StatusTypeDef transmitBlocking (uint8_t * buffer, uint16_t n, uint32_t timeout = __UINT32_MAX__)
    {
        halStatus = HAL_SPI_Transmit(&parameters, buffer, n, timeout);
        return halStatus;
    }

    /**
     * @brief Receive an amount of data in blocking mode.
     */
    inline HAL_StatusTypeDef receiveBlocking (uint8_t * buffer, uint16_t n, uint32_t timeout = __UINT32_MAX__)
    {
        halStatus = HAL_SPI_Receive(&parameters, buffer, n, timeout);
        return halStatus;
    }

    /**
     * @brief Check whether the SPI communication is completed.
     */
    inline bool isBusy () const
    {
        return (((parameters.Instance->SR) & (SPI_FLAG_BSY)) == (SPI_FLAG_BSY));
    }

    /**
     * @brief Send a char in blocking mode.
     */
    inline void putChar (uint8_t data)
    {
        HAL_SPI_Transmit(&parameters, &data, 1, __UINT32_MAX__);
    }
};

/**
 * @brief Class that implements SPI interface.
 */
class AsyncSpi : public BaseSpi, public SharedDevice
{
public:

    /**
     * @brief Default constructor.
     */
    AsyncSpi (const HardwareLayout::Spi & _device, uint32_t _pull);

    /**
     * @brief Open transmission session with given parameters.
     */
    DeviceStart::Status start (uint32_t direction, uint32_t prescaler,
                               uint32_t dataSize = SPI_DATASIZE_8BIT,
                               uint32_t CLKPolarity = SPI_POLARITY_HIGH,
                               uint32_t CLKPhase = SPI_PHASE_1EDGE);

    /**
     * @brief Close the transmission session.
     */
    void stop ();

    /**
     * @brief Send an amount of data in DMA mode.
     */
    inline HAL_StatusTypeDef transmit (DeviceClient * _client, uint8_t * buffer, uint16_t n)
    {
        startCommunication(_client, State::TX, State::TX_CMPL);
        halStatus = HAL_SPI_Transmit_DMA(&parameters, buffer, n);
        return halStatus;
    }

    /**
     * @brief Send an amount of data in interrupt mode.
     */
    inline HAL_StatusTypeDef transmitIt (DeviceClient * _client, uint8_t * buffer, uint16_t n)
    {
        startCommunication(_client, State::TX, State::TX_CMPL);
        halStatus = HAL_SPI_Transmit_IT(&parameters, buffer, n);
        return halStatus;
    }

    /**
     * @brief Receive an amount of data in DMA mode.
     */
    inline HAL_StatusTypeDef receive (DeviceClient * _client, uint8_t * buffer, uint16_t n)
    {
        startCommunication(_client, State::RX, State::RX_CMPL);
        halStatus = HAL_SPI_Receive_DMA(&parameters, buffer, n);
        return halStatus;
    }

    /**
     * @brief Receive an amount of data in interrupt mode.
     */
    inline HAL_StatusTypeDef receiveIt (DeviceClient * _client, uint8_t * buffer, uint16_t n)
    {
        startCommunication(_client, State::RX, State::RX_CMPL);
        halStatus = HAL_SPI_Receive_IT(&parameters, buffer, n);
        return halStatus;
    }

    /**
     * @brief Interrupt handling.
     */
    inline void processInterrupt ()
    {
        HAL_SPI_IRQHandler(&parameters);
    }
};


} // end namespace
#endif
#endif
